jsenlas/KiCAD_Bak/Rozlozenie_pinov.png

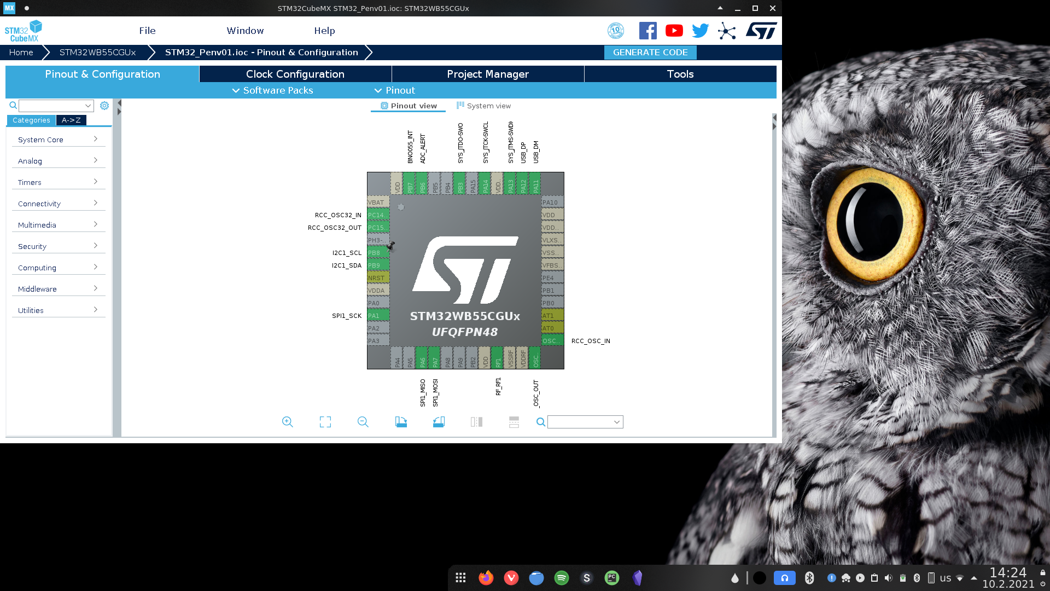
Rozlozenie_pinov.png
