jsenlas/KiCAD_Bak/README.md

# KiCAD_Bak
Bachelor thesis HW section - KiCAD
