jsenlas/KiCAD_Bak/Pinout.ods

1 | VBAT | Power |  | OK
2 | OSC32768IN |  | OSC | OK
3 | OSC32768OUT |  | OSC | OK
4 | PH3-BOOT0 | I/O | BOOT | OK
5 | PB8 | I/O | I2C1_SCL | OK
6 | PB9 | I/O | I2C1_SDA | OK
7 | NRST | Reset | NRST | OK
8 | VDDA | Power |  | OK
9 | PA0 | I/O
10 | PA1 | I/O | SPI1_SCK | OK
11 | PA2 | I/O
12 | PA3 | I/O
13 | PA4 | I/O | LED BLUE | OK | 10
14 | PA5 | I/O
15 | PA6 | I/O | SPI1_MISO | OK
16 | PA7 | I/O | SPI1_MOSI | OK
17 | PA8 | I/O
18 | PA9 | I/O
19 | PB2 | I/O
20 | VDD | Power |  | OK
21 | RF1 | MonoIO | RF_RF1 | Need check
22 | VSSRF | Power |  | OK
23 | VDDRF | Power |  | OK
24 | OSC_OUT | MonoIO | RCC_OSC_OUT | OK
25 | OSC_IN | MonoIO | RCC_OSC_IN | OK | 8
26 | AT0 | NC
27 | AT1 | NC
28 | PB0 | I/O
29 | PB1 | I/O
30 | PE4 | I/O
31 | VFBSMPS | Power |  | OK
32 | VSSSMPS | Power |  | OK
33 | VLXSMPS | Power |  | OK
34 | VDDSMPS | Power |  | OK
35 | VDD | Power |  | OK
36 | PA10 | I/O
37 | PA11 | I/O | USB_DM | OK
38 | PA12 | I/O | USB_DP | OK
39 | PA13 | I/O
40 | VDDUSB | Power |  | OK
41 | PA14 | I/O
42 | PA15 | I/O
43 | PB3 | I/O
44 | PB4 | I/O
45 | PB5 | I/O
46 | PB6 | I/O
47 | PB7 | I/O
48 | VDD | Power |  | OK | 9
ADS115 | OK
BNO055 | OK
