jsenlas/KiCAD_Bak/rozlozeniePinovv1.1.png

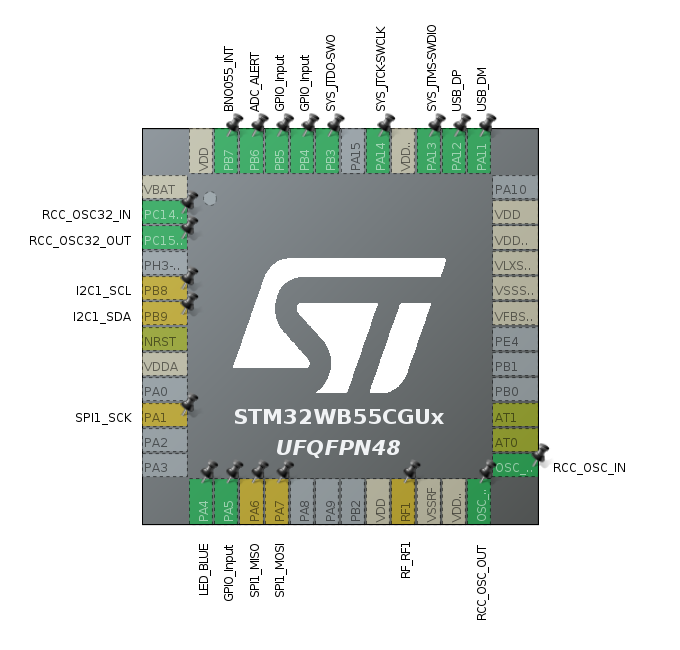
rozlozeniePinovv1.1.png
