jsenlas/KiCAD_Bak/BOM_Senčák HW.xlsx

Sheet: List 1
Položka | Množství | Stav | Odkaz | Poznámka
Adruino Nano | 1 | Vydáno | https://www.gme.cz/klon-arduino-nano-v3-0-r3-ch340g | Sakin osobní
Bluetooth modul HC-05 | 1 | Vydáno | https://www.gme.cz/bluetooth-modul-hc-05 | Sakin osobní
Akcelerometr GY-512 (S106) | 1 | Vydáno | https://blog.laskarduino.cz/gy-521-akcelerometr-gyro-3d-simulace/ | labiny SEM
Tlakový senzor SEN0065 DFROBOT | 5 | Vydáno | https://www.tme.eu/cz/details/df-sen0065/ostatni-cidla/dfrobot/sen0065/ | labiny SEM
Breadboard | 2 | Vydáno | https://www.adafruit.com/product/64 | labiny SEM
Adaptér micro SD | 1 | Vydáno | https://www.tme.eu/cz/details/df-dfr0229/adaptery/dfrobot/dfr0229/ | projekty
Odpory 30k, 102k, 10k | 20 x 3 | Vydáno | https://www.gme.cz/
Plochý vícežilový kabel VFL 10x0,15 | 5 | Vydáno | https://www.gme.cz/plochy-vicezilovy-kabel-vfl-10x0-15
Univerzální plošný spoj UP931EP | 1 | Vydáno | https://www.gme.cz/univelzalni-spoj-160-x-100-rm-2-54-kulate-body-din-41612
Věčný hrot k trafopáječce 1mm | 2 | Vydáno | https://www.gme.cz/vecny-hrot-k-trafopajecce-1mm
Cín 1mm 100g | 1 | Vydáno | https://www.gme.cz/cinova-pajka-cin-1mm-100g-sn99-3cu0-7nip-pbfree
microUSB pin UB-MC5BR3-SDWP604-4S-TF JST | 2 | v kanclu | https://www.tme.eu/cz/details/ubmc5br3sdwp6044s/konektory-usb-a-ieee1394/jst/ub-mc5br3-sdwp604-4s-tf/
MCP1640CT-I/CHY MICROCHIP měnič DC/DC | 5 | v kanclu | https://www.tme.eu/en/details/mcp1640ct-i_chy/voltage-regulators-dc-dc-circuits/microchip-technology/ | 5x lebo je to celkom lacne a potrebujem si to skusit na necisto
STM32WB55CGU6 Mikrokontrolér, STM32 | 1 | v kanclu | ST32_3D:STM32WB55CGU7 | https://www.mouser.sk/ProductDetail/STMicroelectronics/STM32WB55CGU6TR/?qs=vLWxofP3U2xiqLUzBgGZzw== |  | Mal by to byt tento, ten popisok je asi zly, neviemako sa tam dostal, radsej ho tam necham
FSR04BE Ohmite dotykové čidlo | 3 | v kanclu | https://cz.mouser.com/ProductDetail/Ohmite/FSR04BE/?qs=byeeYqUIh0N2f2m9cyusJg==
BNO055 9-axis gyroskopy, senzor pohybu | 1 | Objednáno | https://cz.mouser.com/ProductDetail/Bosch-Sensortec/BNO055/?qs=QhAb4EtQfbV8Z2YmISucWw== | Je celkom rozsireny a Bosch ma velku kniznicu
ADS1115IRUGR A/D prevodnik | 1 | v kanclu | https://cz.mouser.com/ProductDetail/Texas-Instruments/ADS1115IRUGR/?qs=IK5e5L0zOXhqw%2F8AHSSbuA== | Tento uz pouzivam v tom co mam
Krystal NX2012SA-32.768K-STD-MUB-1 | 1 | Objednáno | https://cz.mouser.com/ProductDetail/NDK/NX2012SA-32768K-STD-MUB-1/?qs=55YtniHzbhA%252B6%2Fl1MwFZaQ==
Doobjednať su tu vsetky suciastky so spravnymi poctami do objednavky. Na druhej stranke je zoznam vsetkych komponent v mojej scheme, zoskupene podla suciastok s poctami
100n C1,5,6,7,8,9,10,19,21 | 9 | Neobj | https://www.mouser.sk/ProductDetail/Yageo/CC0402JRX7R8BB104/?qs=tS%2FAHvPQ%2F56C6Jcuby2Lxg%3D%3D
100p C2 | 1 | Neobj | https://www.mouser.sk/ProductDetail/AVX/04026C101KAT2A/?qs=nyfP64xlqc%2FN9ABjcoge4g%3D%3D
4u7 C3,4,13 | 3 | Neobj | https://www.mouser.sk/ProductDetail/Murata-Electronics/GRT155C80J475ME13D/?qs=rrS6PyfT74fcISTT255Zog%3D%3D
1u C11,16 | 2 | Neobj | https://www.mouser.sk/ProductDetail/Taiyo-Yuden/LMK105BJ105MVHF/?qs=sBf%2Fb4nBSlfFq2d5eQRmhw%3D%3D
100n C12 | 1 | Neobj | https://www.mouser.sk/ProductDetail/Yageo/CC0201KRX6S6BB104/?qs=tS%2FAHvPQ%2F55Jn9CaHON1Eg%3D%3D |  | Bosch chce este jeden
10n C14 | 1 | Neobj | https://www.mouser.sk/ProductDetail/Murata-Electronics/GCB155M91A103KE01D/?qs=rrS6PyfT74f9uJD9nibAXg%3D%3D
100n C15 | 1 | Neobj | https://www.mouser.sk/ProductDetail/AVX/04026D104KAT2A/?qs=LLG2yGGJ5NhILwMziGI8Xg%3D%3D
4p3 C17,18 | 2 | Neobj | https://www.mouser.sk/ProductDetail/KEMET/C0402C439B5GACTU/?qs=sGAEpiMZZMuMW9TJLBQkXtQELi8n00gZ9Z2MeBGZChc%3D
1u C20,22,23 | 3 | Neobj | https://www.mouser.sk/ProductDetail/Murata-Electronics/GRT155C80J105KE01D/?qs=drgMNd%252BkGPPklTH3DFv1UA%3D%3D
22p C24,25 | 2 | Neobj | https://www.mouser.sk/ProductDetail/KEMET/C0402C220J5GAC7411/?qs=G1g%2FCI6Oc7%252BpkCDhmQb%252B2A%3D%3D
10u C_1 | 1 | Neobj | https://www.mouser.sk/ProductDetail/Murata-Electronics/GRJ155R60J106ME11D/?qs=I53XXhTNm8s0qq2xY2TjBg%3D%3D
D1 Blue | 1 | Neobj | https://www.mouser.sk/ProductDetail/OSRAM-Opto-Semiconductors/LG-L29K-F2J1-24-Z/
D3 | 1 | Neobj | https://www.mouser.sk/ProductDetail/Diodes-Incorporated/1N4148WT-7/?qs=FITO%2F%2FQgYDlMYETivVNccQ%3D%3D
ed1 | 1 | Neobj | https://www.mouser.sk/ProductDetail/Taoglas/RECE-20279-001E-01/?qs=WUa1z%2FNV9%252B3mVij1vDlP0A%3D%3D
FB1 BLM15AX601SN1D | 1 | Neobj | https://www.mouser.sk/ProductDetail/Murata-Electronics/BLM15AX601SN1D/?qs=MY6wChARw2zrjX4xpWbUQA%3D%3D
FB2,3 MMZ2012Y152BTD25 | 2 | Neobj | https://www.mouser.sk/ProductDetail/TDK/MMZ2012Y152BTD25?qs=z4cHi%252BdwYubbRRUCER1uug%3D%3D
FL1 MLPF-WB55-01E3 | 1 | Neobj | https://www.mouser.sk/ProductDetail/STMicroelectronics/MLPF-WB55-02E3/
IC1 LD3985M33R | 1 | Neobj | https://www.mouser.sk/ProductDetail/STMicroelectronics/LD3985M33R/
IC2 USBLC6-2SC6 | 1 | Neobj | https://www.mouser.co.uk/ProductDetail/STMicroelectronics/USBLC6-2SC6/?qs=po45yt2pPpu%2FhNIlwQdTlg%3D%3D
J1 USB | 1 | v kanclu | https://www.tme.eu/cz/details/ubmc5br3sdwp6044s/konektory-usb-a-ieee1394/jst/ub-mc5br3-sdwp604-4s-tf/
L1 | 1 | Neobj | https://www.mouser.sk/ProductDetail/TDK/MLZ1608E4R7MT/?qs=h0qUPQyyc9d3MvAbpnb%252BVQ%3D%3D
L2 | 1 | Neobj | https://www.mouser.sk/ProductDetail/Bourns/PM0603-10NJ-RC/?qs=hDfDVdb8C4gaFG%2FjJv%252Bsvg%3D%3D
L3 | 1 | Neobj | https://www.mouser.sk/ProductDetail/KEMET/L0603C10NJRMST/?qs=v1sh8PPj49i58Ne9vk%2F5nA%3D%3D
100K LED R1,5,7,8,9, | 5 | Neobj | https://www.mouser.sk/ProductDetail/Welwyn-Components-TT-Electronics/WCR0402-100KFA/
10K R2,3,4,6,10,11,12 | 7 | Neobj | https://www.mouser.sk/ProductDetail/Vishay-Dale/CRCW040210K0FKEDC/?qs=E3Y5ESvWgWPiNLcGzwCGPg%3D%3D
976K R_1 | 1 | Neobj | https://www.mouser.sk/ProductDetail/Vishay-Dale/CRCW0402976KFKED/
562K R_2 | 1 | Neobj | https://www.mouser.sk/ProductDetail/Vishay-Dale/CRCW0402562KFKED/
S1,2 MLL1200S | 2 | Neobj | https://www.mouser.sk/ProductDetail/TE-Connectivity-PB/MLL1200S/?qs=%252BHgkcFtPSlhaU4bDJZHWiQ%3D%3D
U1 | 1 | v kanclu | https://www.tme.eu/en/details/mcp1640ct-i_chy/voltage-regulators-dc-dc-circuits/microchip-technology/
U2 | 1 | v kanclu | https://www.mouser.sk/ProductDetail/STMicroelectronics/STM32WB55CGU6TR/?qs=vLWxofP3U2xiqLUzBgGZzw==
U4 | 1 | Objednáno | https://cz.mouser.com/ProductDetail/Bosch-Sensortec/BNO055/?qs=QhAb4EtQfbV8Z2YmISucWw==
U5 | 1 | v kanclu | https://cz.mouser.com/ProductDetail/Texas-Instruments/ADS1115IRUGR/?qs=IK5e5L0zOXhqw%2F8AHSSbuA==
Y1 | 1 | Neobj | https://www.mouser.sk/ProductDetail/NDK/NX2520SA-32000M-STD-CSW-2/
Y2,3 | 1 | Neobj | https://cz.mouser.com/ProductDetail/NDK/NX2012SA-32768K-STD-MUB-1/?qs=55YtniHzbhA%252B6%2Fl1MwFZaQ==
FSR04 | 3 | v kanclu | https://cz.mouser.com/ProductDetail/Ohmite/FSR04BE/?qs=byeeYqUIh0N2f2m9cyusJg==
Dalsie
Shottky |  | Neobj | https://www.mouser.sk/ProductDetail/Vishay-Semiconductors/BAT54W-HE3-08/?qs=ESFF34UzhwicvMTEyztCgA%3D%3D
LQG15HS2N7S02D |  | Neobj | https://www.tme.eu/en/details/lqg15hs2n7s02d/smd-0402-inductors/murata/
Antena FXP75.07.0045B |  | Neobj | https://www.mouser.sk/ProductDetail/Taoglas/FXP75070045B/?qs=gAfoL%252BRo%2FrIkDsQ4mxrg%2Fw%3D%3D
TOTO su suciastky ktore nechcem, zistil som ze ich netreba, ci uz som ich nahradil inymi alebo som zmenil dizajn podla niektorej application note
RF OLD
SMD Multilayer Ceramic Capacitor GRM1555C1H1R8BA01D |  | X | https://uk.farnell.com/murata/grm1555c1h1r8ba01d/cap-1-8pf-50v-c0g-np0-0402/dp/2456093
Band Pass Filter 2.45GHz |  | X | https://www.mouser.sk/ProductDetail/TDK/DEA162450BT-1295A1/?qs=r5DSvlrkXmJWOg7G%2F4pSbg%3D%3D
Band Pass Filter 2.45GHz Alternativa. Len jedno treba vybrat |  | X | https://www.mouser.sk/ProductDetail/Taiyo-Yuden/FI168B245001-T/?qs=I6KAKw0tg2xuNK6sNGcrog%3D%3D
4.7 uH 1640 L |  |  | https://www.mouser.sk/ProductDetail/Wurth-Elektronik/744030004/
ECMF02-2AMX6 | 2 | X | https://www.mouser.sk/productdetail/stmicroelectronics/ecmf02-2amx6?qs=raAh8RbVwI65u5gmT42%2Flg==
ESDA7P60-1U1M | 2 | X | https://www.mouser.sk/ProductDetail/STMicroelectronics/ESDA7P60-1U1M/

Sheet: List 2
Suciastky | Pocet | Stav | Odkaz | Zoznam vsetkych komponent, ktore mam na doske spolu s poctami, podla tohoto NEOBJEDNAVAT
100n C1,5,6,7,8,9,10,19,21 | 9 | Neobj | https://www.mouser.sk/ProductDetail/Yageo/CC0402JRX7R8BB104/?qs=tS%2FAHvPQ%2F56C6Jcuby2Lxg%3D%3D
100p C2 | 1 | Neobj | https://www.mouser.sk/ProductDetail/AVX/04026C101KAT2A/?qs=nyfP64xlqc%2FN9ABjcoge4g%3D%3D
4u7 C3,4,13 | 3 | Neobj | https://www.mouser.sk/ProductDetail/Murata-Electronics/GRT155C80J475ME13D/?qs=rrS6PyfT74fcISTT255Zog%3D%3D
1u C11,16 | 2 | Neobj | https://www.mouser.sk/ProductDetail/Taiyo-Yuden/LMK105BJ105MVHF/?qs=sBf%2Fb4nBSlfFq2d5eQRmhw%3D%3D
100n C12 | 1 | Neobj | https://www.mouser.sk/ProductDetail/Yageo/CC0201KRX6S6BB104/?qs=tS%2FAHvPQ%2F55Jn9CaHON1Eg%3D%3D
10n C14 | 1 | Neobj | https://www.mouser.sk/ProductDetail/Murata-Electronics/GCB155M91A103KE01D/?qs=rrS6PyfT74f9uJD9nibAXg%3D%3D
100n C15 | 1 | Neobj | https://www.mouser.sk/ProductDetail/AVX/04026D104KAT2A/?qs=LLG2yGGJ5NhILwMziGI8Xg%3D%3D
4p3 C17,18 | 2 | Neobj | https://www.mouser.sk/ProductDetail/KEMET/C0402C439B5GACTU/?qs=sGAEpiMZZMuMW9TJLBQkXtQELi8n00gZ9Z2MeBGZChc%3D
1u C20,22,23 | 3 | Neobj | https://www.mouser.sk/ProductDetail/Murata-Electronics/GRT155C80J105KE01D/?qs=drgMNd%252BkGPPklTH3DFv1UA%3D%3D
22p C24,25 | 2 | Neobj | https://www.mouser.sk/ProductDetail/KEMET/C0402C220J5GAC7411/?qs=G1g%2FCI6Oc7%252BpkCDhmQb%252B2A%3D%3D
10u C_1 | 1 | Neobj | https://www.mouser.sk/ProductDetail/Murata-Electronics/GRJ155R60J106ME11D/?qs=I53XXhTNm8s0qq2xY2TjBg%3D%3D
D1 Blue | 1 | Neobj | https://www.mouser.sk/ProductDetail/OSRAM-Opto-Semiconductors/LG-L29K-F2J1-24-Z/
D3 | 1 | Neobj | https://www.mouser.sk/ProductDetail/Diodes-Incorporated/1N4148WT-7/?qs=FITO%2F%2FQgYDlMYETivVNccQ%3D%3D
ed1 | 1 | Neobj | https://www.mouser.sk/ProductDetail/Taoglas/RECE-20279-001E-01/?qs=WUa1z%2FNV9%252B3mVij1vDlP0A%3D%3D
FB1 BLM15AX601SN1D | 1 | Neobj | https://www.mouser.sk/ProductDetail/Murata-Electronics/BLM15AX601SN1D/?qs=MY6wChARw2zrjX4xpWbUQA%3D%3D
FB2,3 MMZ2012Y152BTD25 | 2 | Neobj | https://www.mouser.sk/ProductDetail/TDK/MMZ1005A152ETD25/?qs=pvNC7ksEVIcCEaWw1qDBfg%3D%3D
FL1 MLPF-WB55-01E3 | 1 | Neobj | https://www.mouser.sk/ProductDetail/STMicroelectronics/MLPF-WB55-02E3/
IC1 LD3985M33R | 1 | Neobj | https://www.mouser.sk/ProductDetail/STMicroelectronics/LD3985M33R/
IC2 | 1 | Neobj | https://www.mouser.co.uk/ProductDetail/STMicroelectronics/USBLC6-2SC6/?qs=po45yt2pPpu%2FhNIlwQdTlg%3D%3D
J1 USB | 1 | v kanclu | https://www.tme.eu/cz/details/ubmc5br3sdwp6044s/konektory-usb-a-ieee1394/jst/ub-mc5br3-sdwp604-4s-tf/
L1 | 1 | Neobj | https://www.mouser.sk/ProductDetail/TDK/MLZ1608E4R7MT/?qs=h0qUPQyyc9d3MvAbpnb%252BVQ%3D%3D
L2 | 1 | Neobj | https://www.mouser.sk/ProductDetail/Bourns/PM0603-10NJ-RC/?qs=hDfDVdb8C4gaFG%2FjJv%252Bsvg%3D%3D
L3 | 1 | Neobj | https://www.mouser.sk/ProductDetail/KEMET/L0603C10NJRMST/?qs=v1sh8PPj49i58Ne9vk%2F5nA%3D%3D
100K LED R1,5,7,8,9, | 5 | Neobj | https://www.mouser.sk/ProductDetail/Welwyn-Components-TT-Electronics/WCR0402-100KFA/
10K R2,3,4,6,10,11,12 | 7 | Neobj | https://www.mouser.sk/ProductDetail/Vishay-Dale/CRCW040210K0FKEDC/?qs=E3Y5ESvWgWPiNLcGzwCGPg%3D%3D
976K R_1 | 1 | Neobj | https://www.mouser.sk/ProductDetail/Vishay-Dale/CRCW0402976KFKED/
562K R_2 | 1 | Neobj | https://www.mouser.sk/ProductDetail/Vishay-Dale/CRCW0402562KFKED/
S1,2 MLL1200S | 2 | Neobj | https://www.mouser.sk/ProductDetail/TE-Connectivity-PB/MLL1200S/?qs=%252BHgkcFtPSlhaU4bDJZHWiQ%3D%3D
U1 | 1 | v kanclu | https://www.tme.eu/en/details/mcp1640ct-i_chy/voltage-regulators-dc-dc-circuits/microchip-technology/
U2 | 1 | v kanclu | https://www.mouser.sk/ProductDetail/STMicroelectronics/STM32WB55CGU6TR/?qs=vLWxofP3U2xiqLUzBgGZzw==
U4 | 1 | Objednáno | https://cz.mouser.com/ProductDetail/Bosch-Sensortec/BNO055/?qs=QhAb4EtQfbV8Z2YmISucWw==
U5 | 1 | v kanclu | https://cz.mouser.com/ProductDetail/Texas-Instruments/ADS1115IRUGR/?qs=IK5e5L0zOXhqw%2F8AHSSbuA==
Y1 | 1 | Neobj | https://www.mouser.sk/ProductDetail/NDK/NX2520SA-32000M-STD-CSW-2/
Y2,3 | 2 | Objednáno/neobj | https://cz.mouser.com/ProductDetail/NDK/NX2012SA-32768K-STD-MUB-1/?qs=55YtniHzbhA%252B6%2Fl1MwFZaQ==
FSR04 | 3 | v kanclu | https://cz.mouser.com/ProductDetail/Ohmite/FSR04BE/?qs=byeeYqUIh0N2f2m9cyusJg==
Zmeny v suciastkach
FB1 Z0805C601BSMST | 1 | Neobj | https://www.mouser.sk/ProductDetail/KEMET/Z0805C601BSMST/?qs=v1sh8PPj49jmDD01hjhyZg==
D1 Blue | 1 | Neobj | https://www.mouser.sk/ProductDetail/ROHM-Semiconductor/SMLP13BC8TT86/?qs=9Cg39qEKpi6LOVes3%252Bc%2Fag%3D%3D
FB2,3 MMZ2012Y152BTD25 | 2 | Neobj | https://www.mouser.sk/ProductDetail/TDK/MMZ2012Y152BTD25?qs=z4cHi%252BdwYubbRRUCER1uug%3D%3D
