jsenlas/KiCAD_Bak/STM32WB55CG/STM32WB55_QFN48_IPD_REF_BOARD/01-Schéma-pdf/Schematic_STM32WB55_DB_QFN48_IPD.PDF

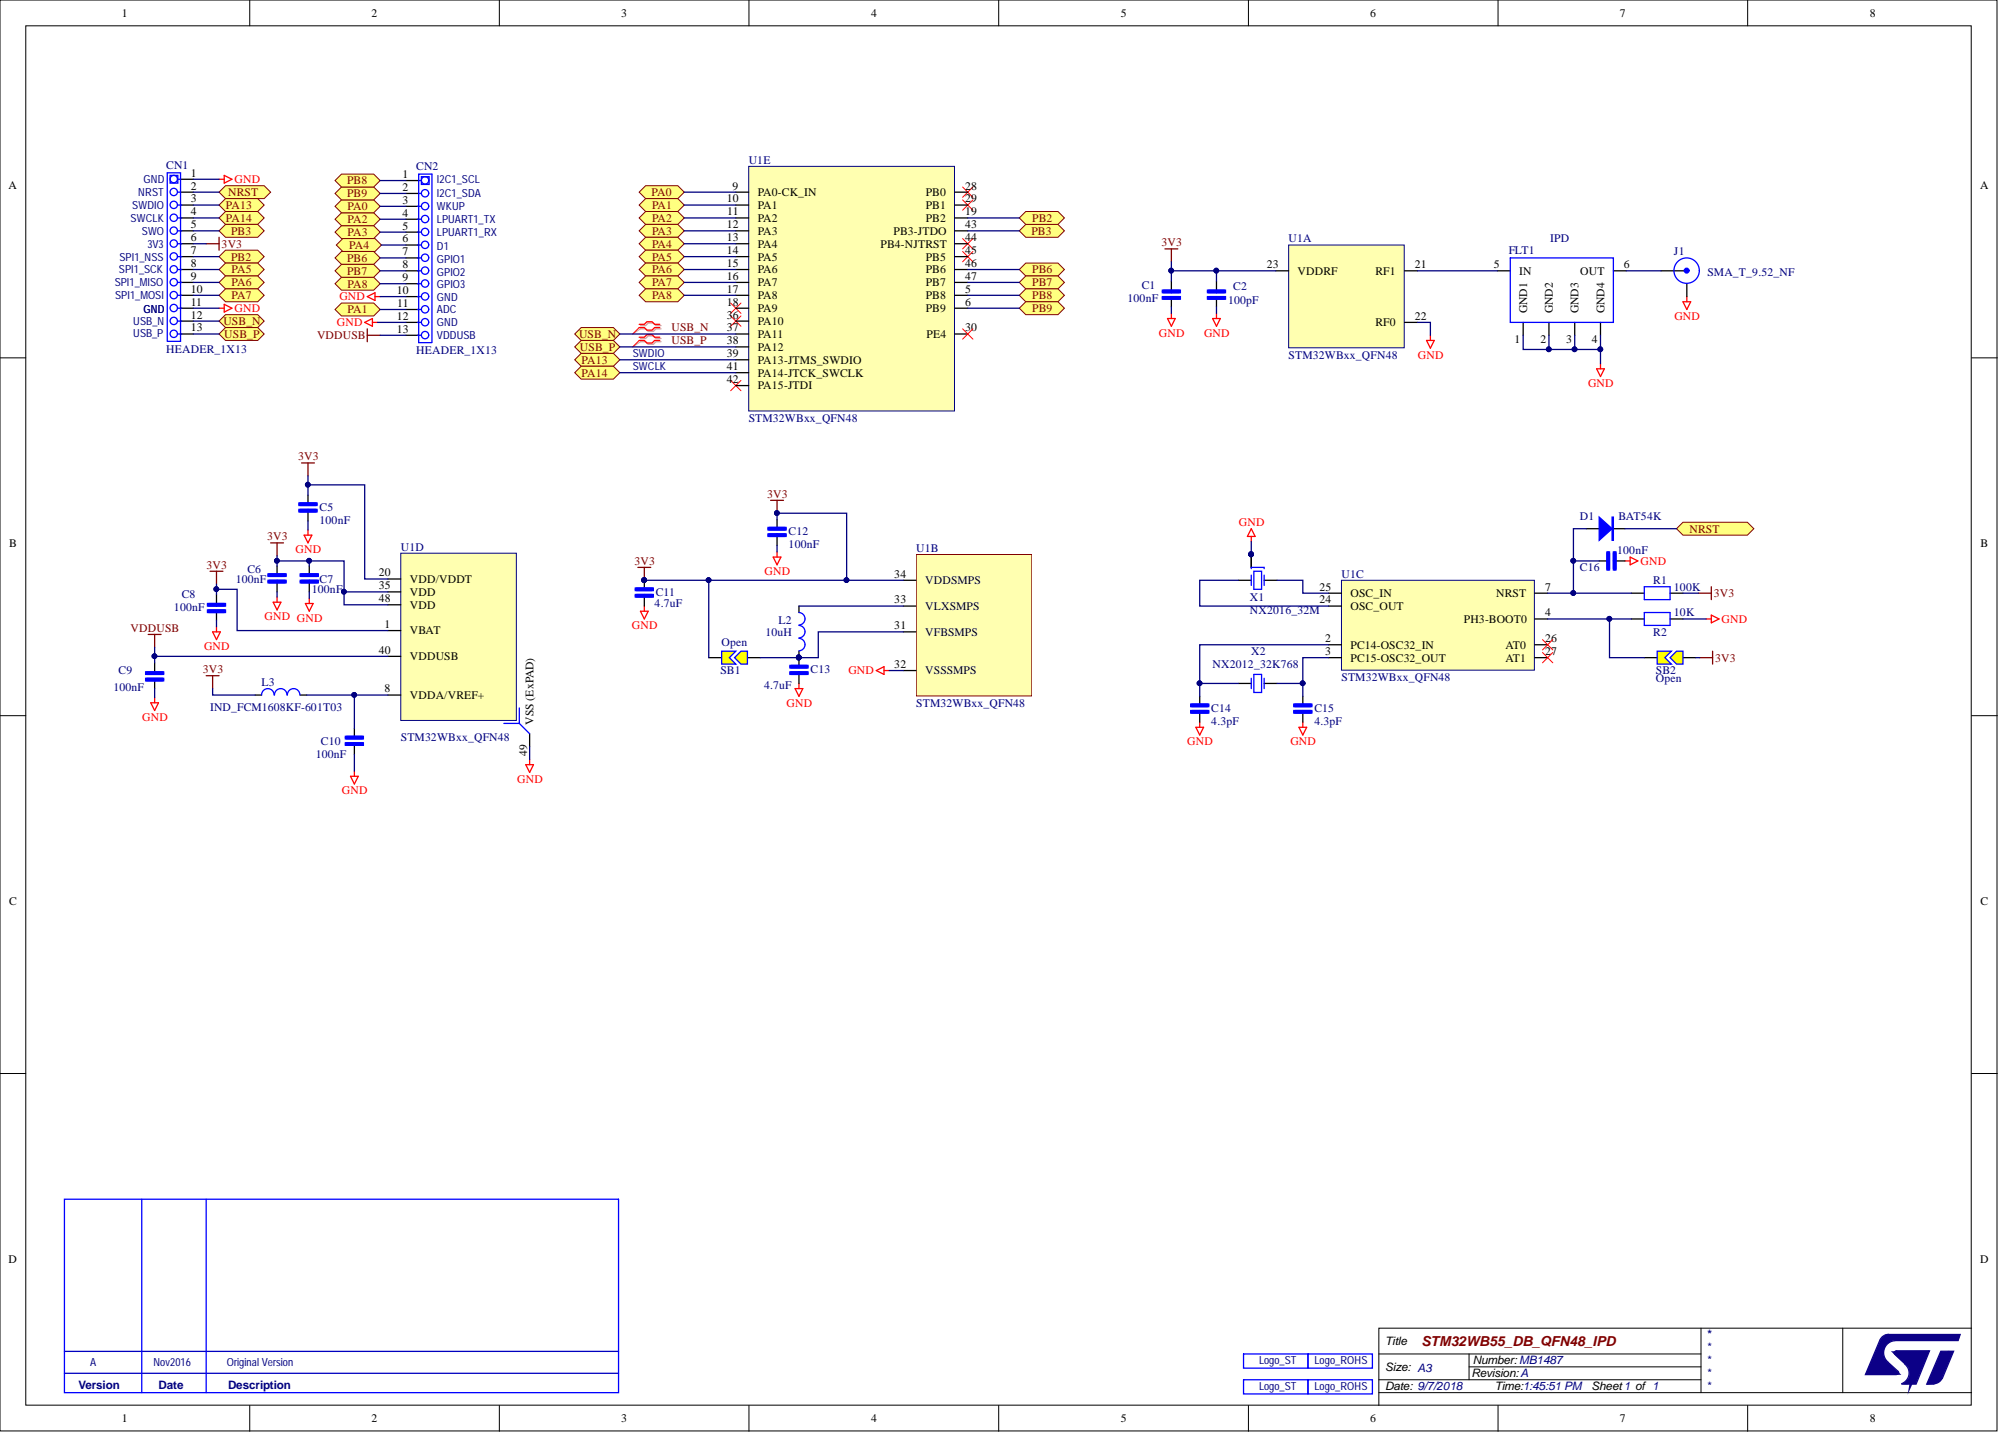
[picture p3: page 1]
