jsenlas/KiCAD_Bak/STM32WB55CG/STM32WB55_QFN48_IPD_REF_BOARD/04-Plan d'équipement-pdf/Assembly_Bottom_STM32WB55_DB_QFN48_IPD.PDF

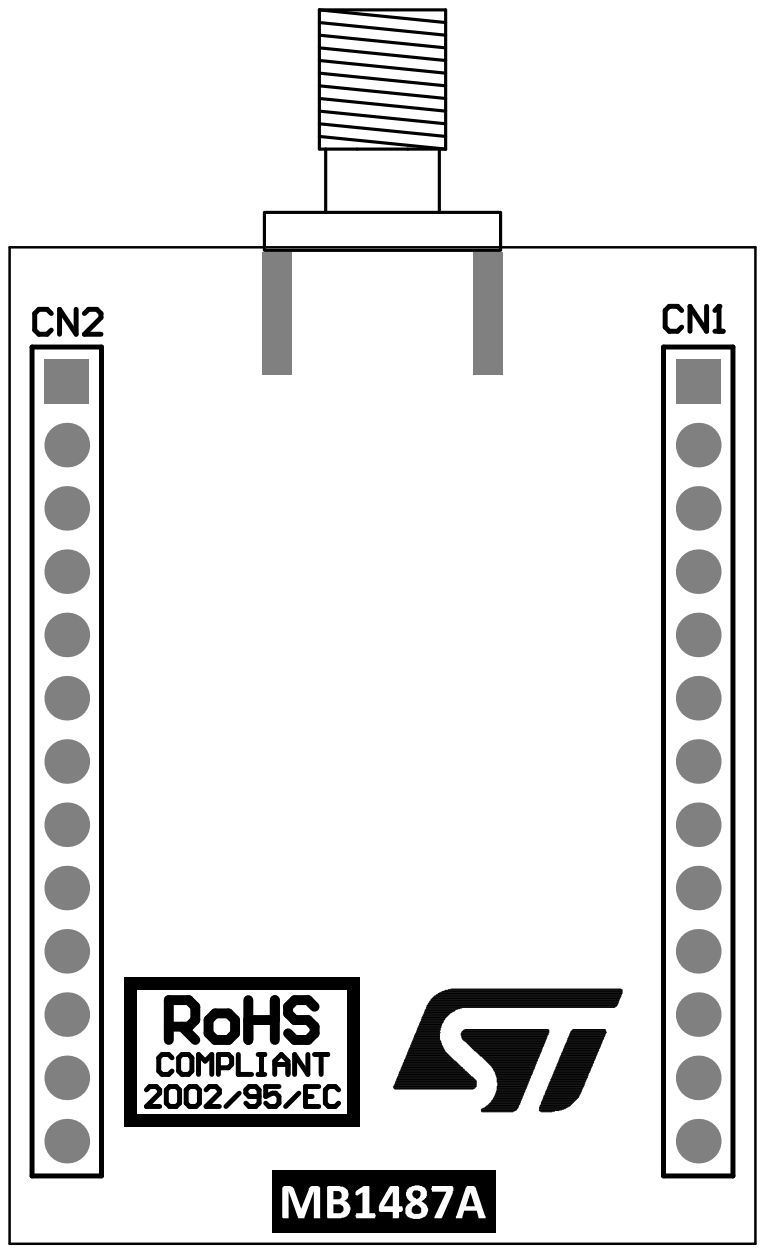
[picture p4: page 1]
