jsenlas/KiCAD_Bak/schv01.3.pdf

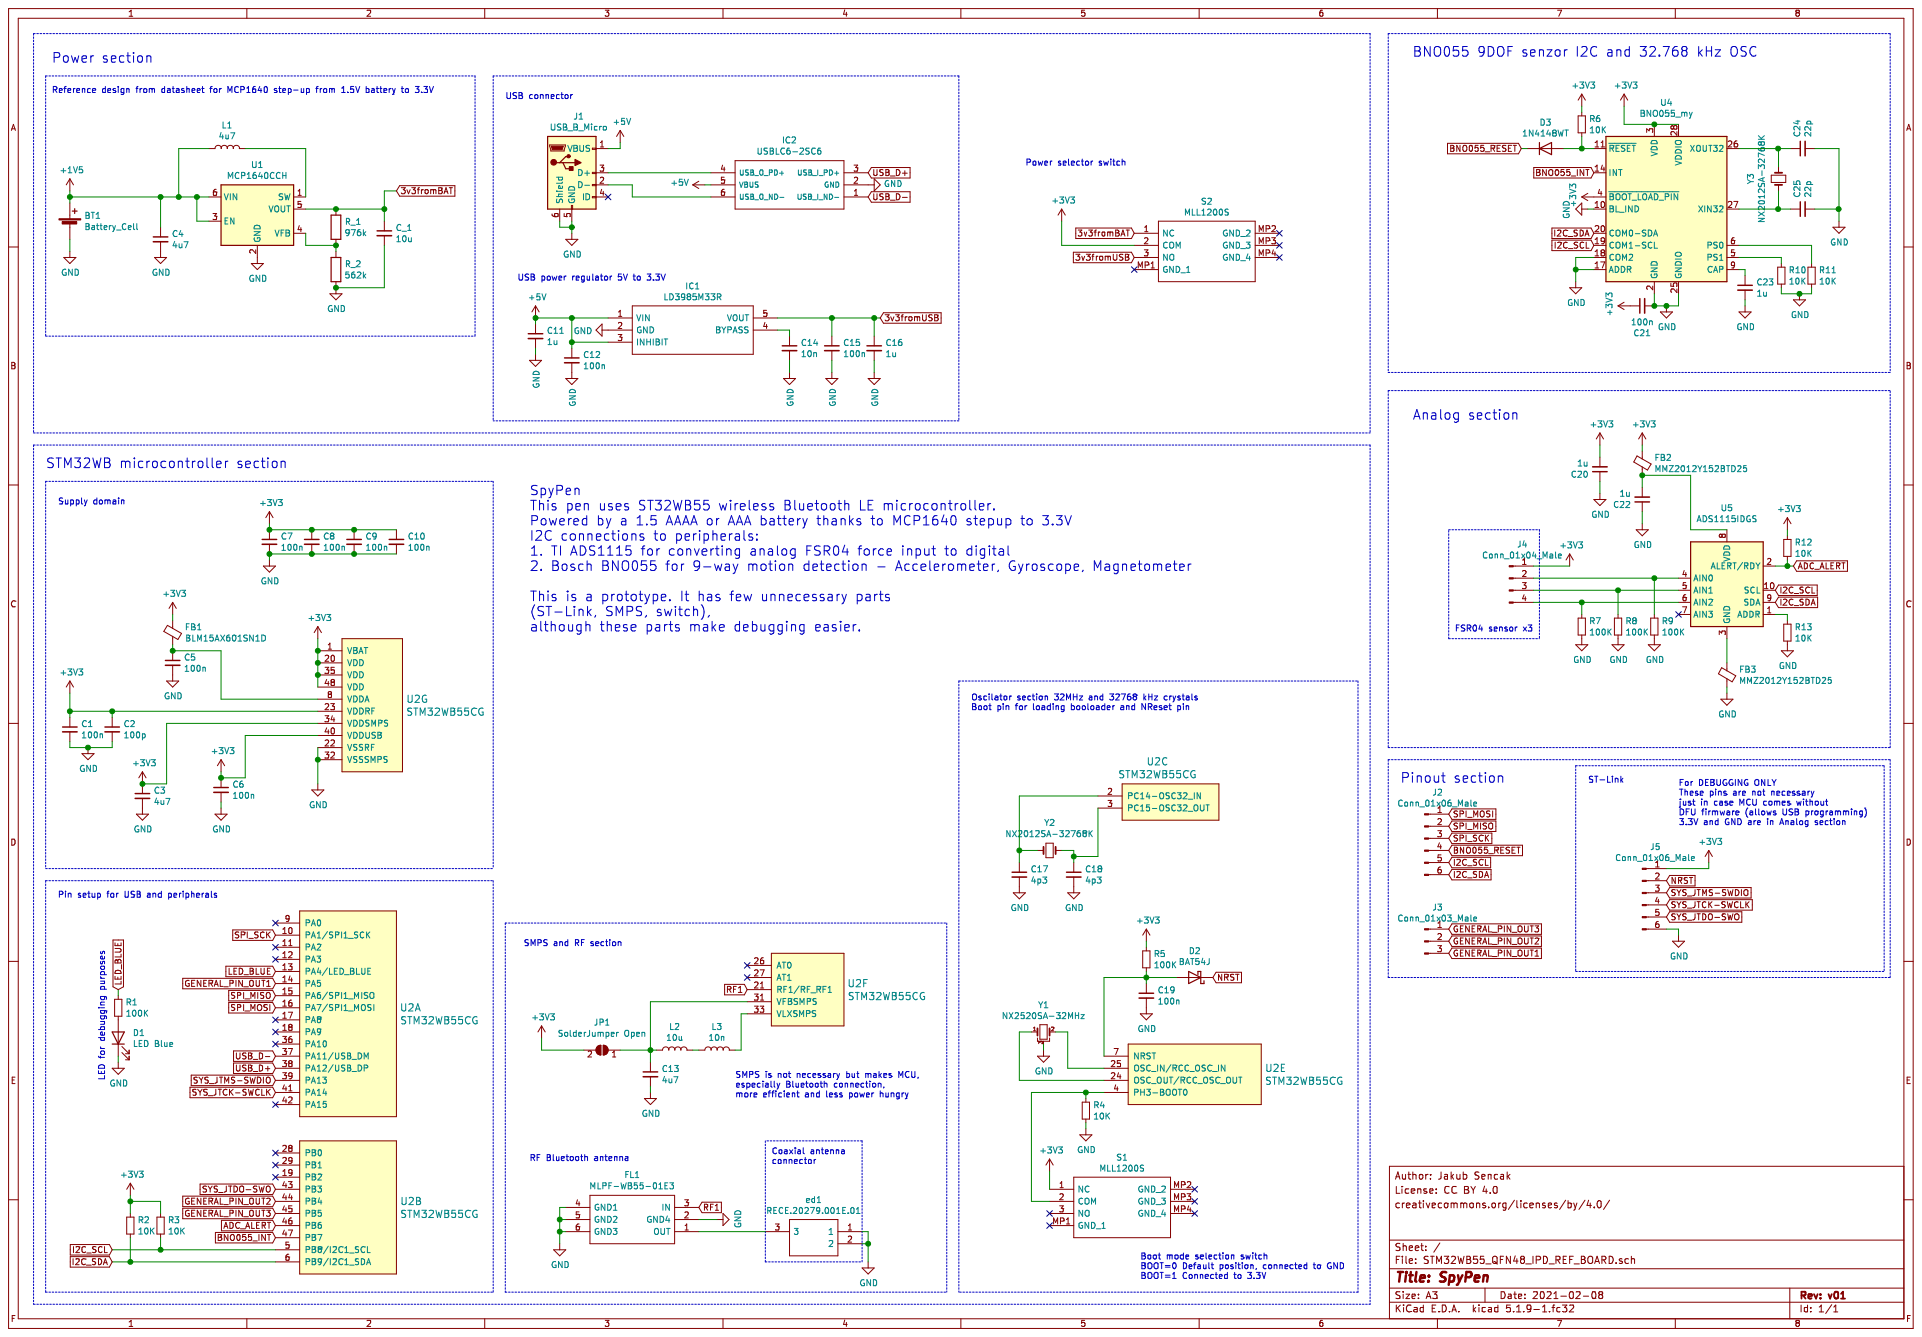
[picture p6: page 1]
