jsenlas/KiCAD_Bak/schv01.2.pdf

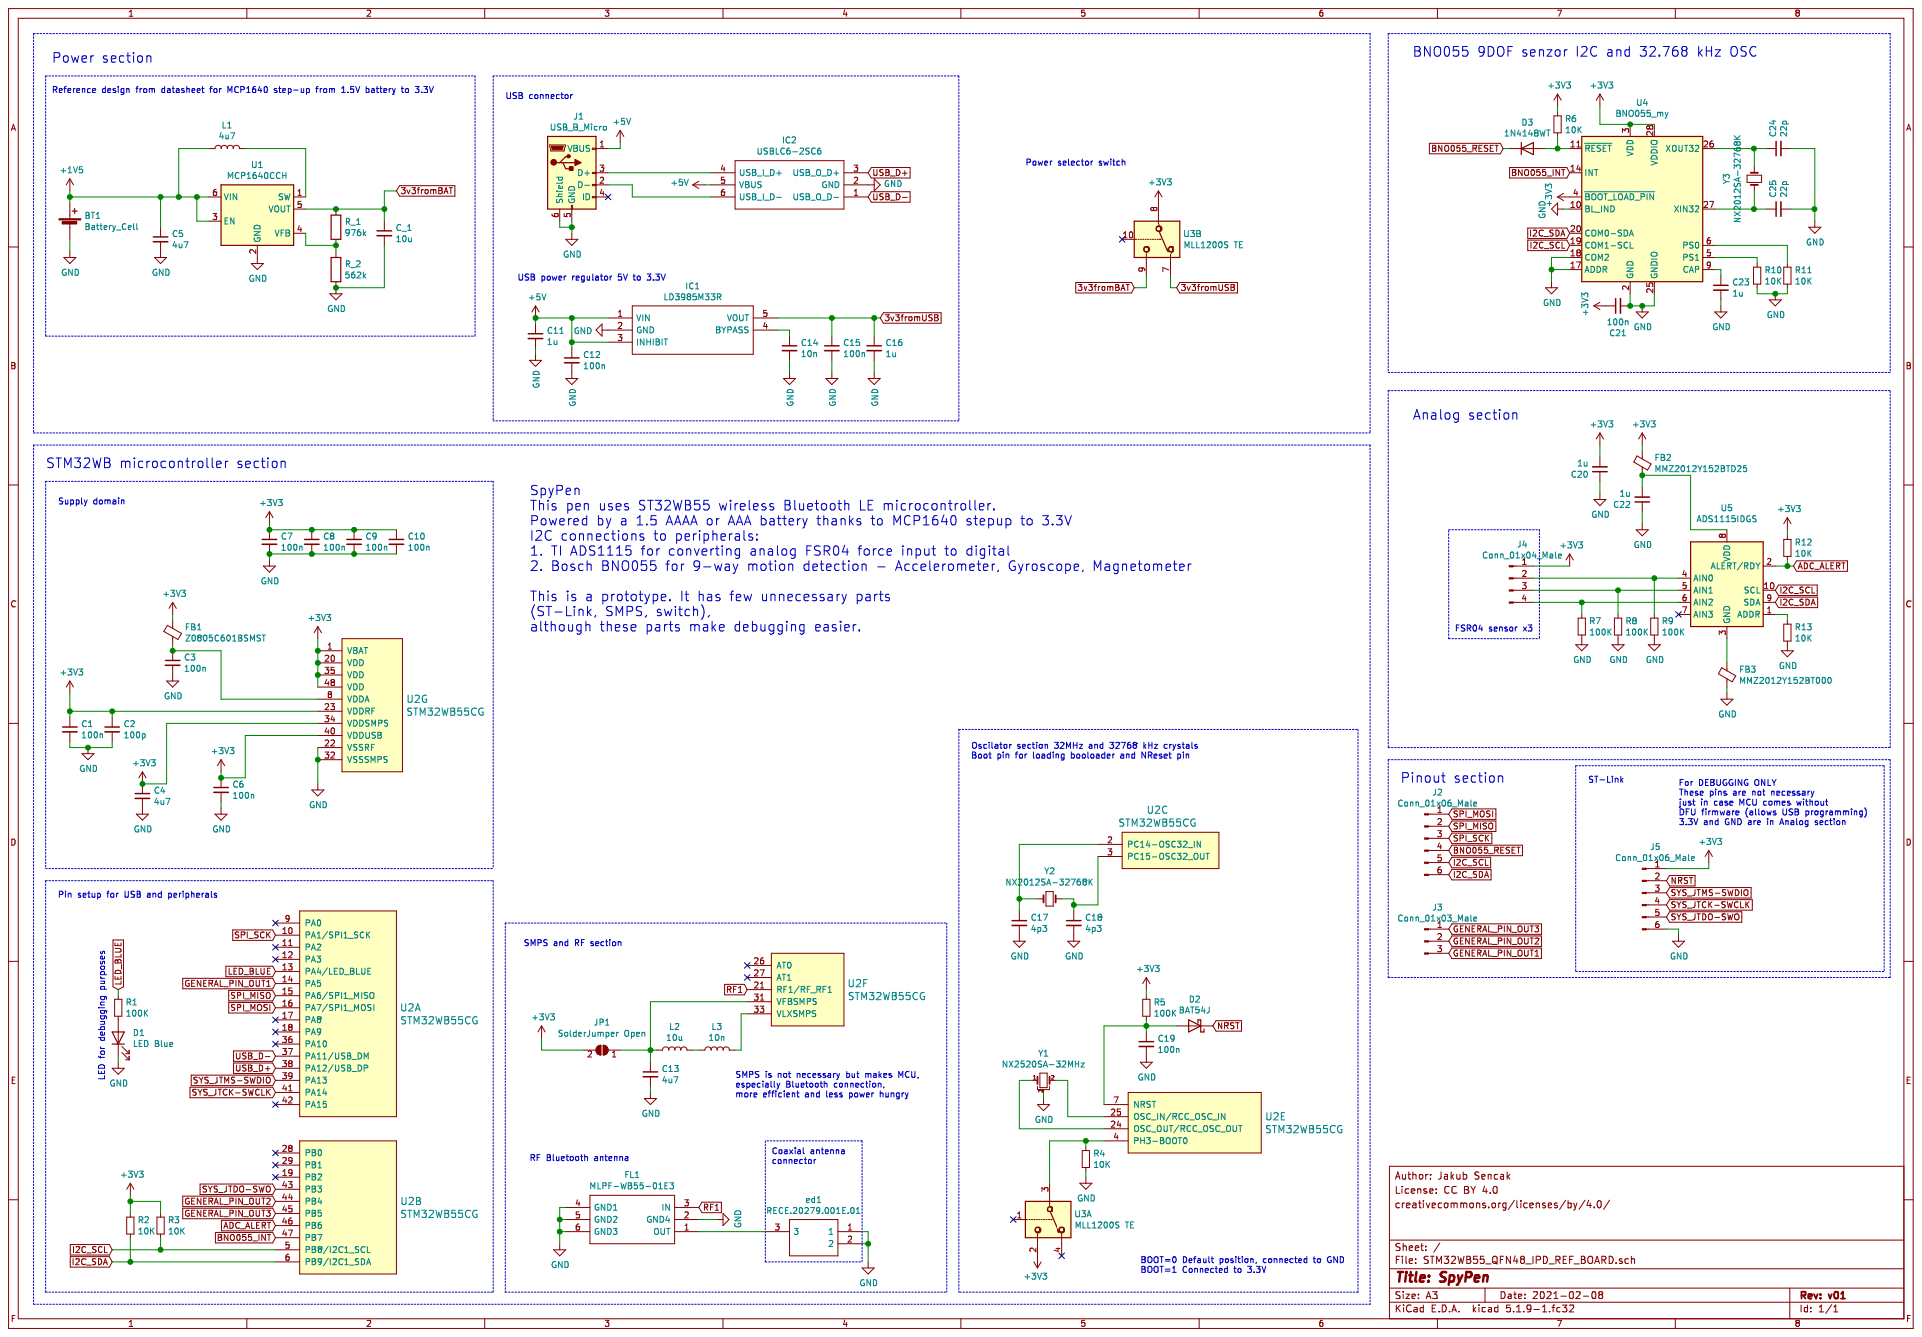
[picture p7: page 1]
