jsenlas/KiCAD_Bak/schv01.1.pdf

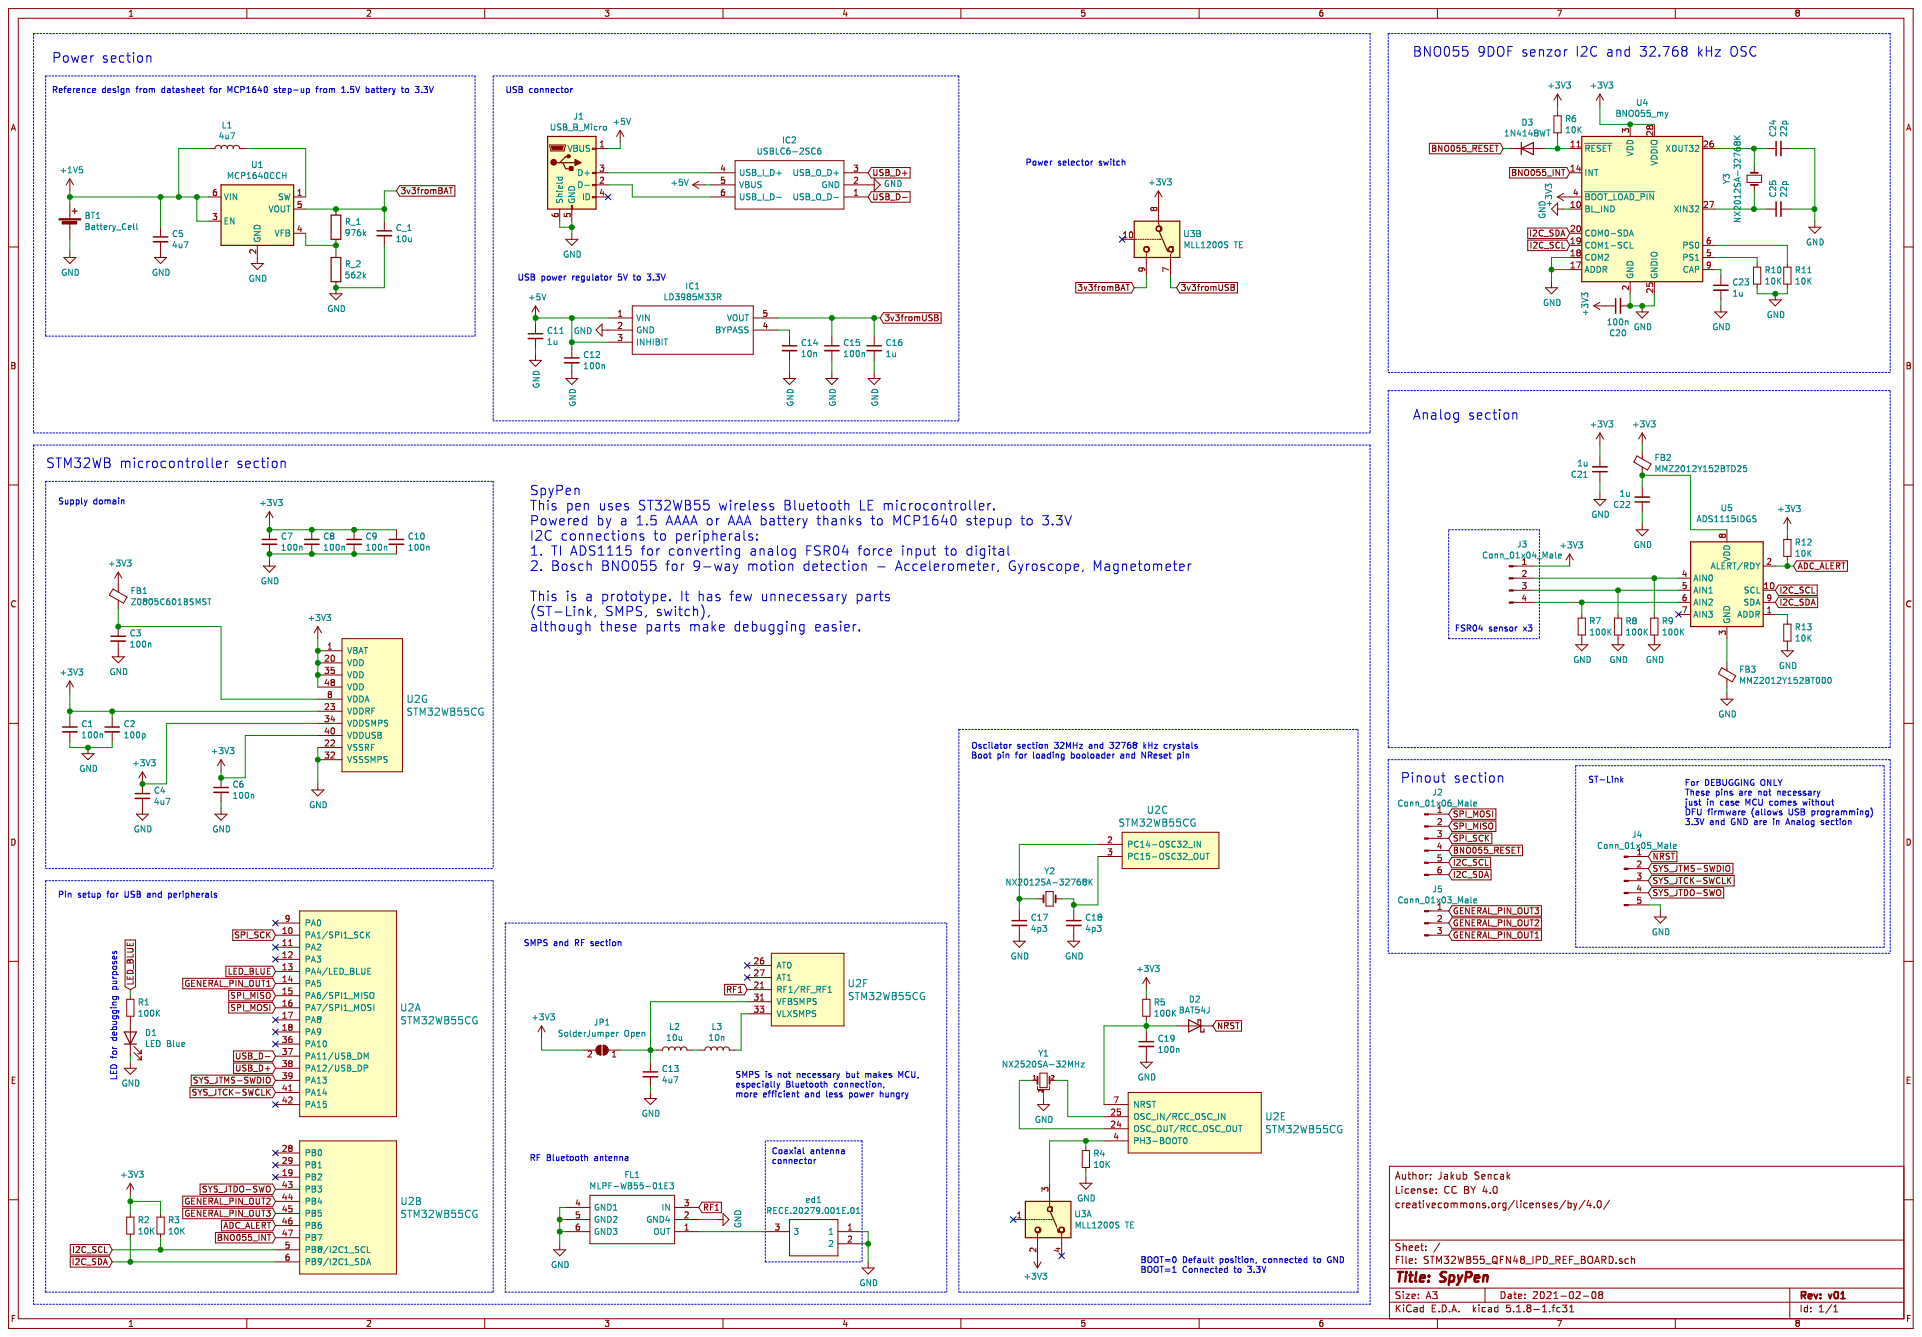
[picture p8: page 1]
