jsenlas/KiCAD_Bak/schv01.pdf

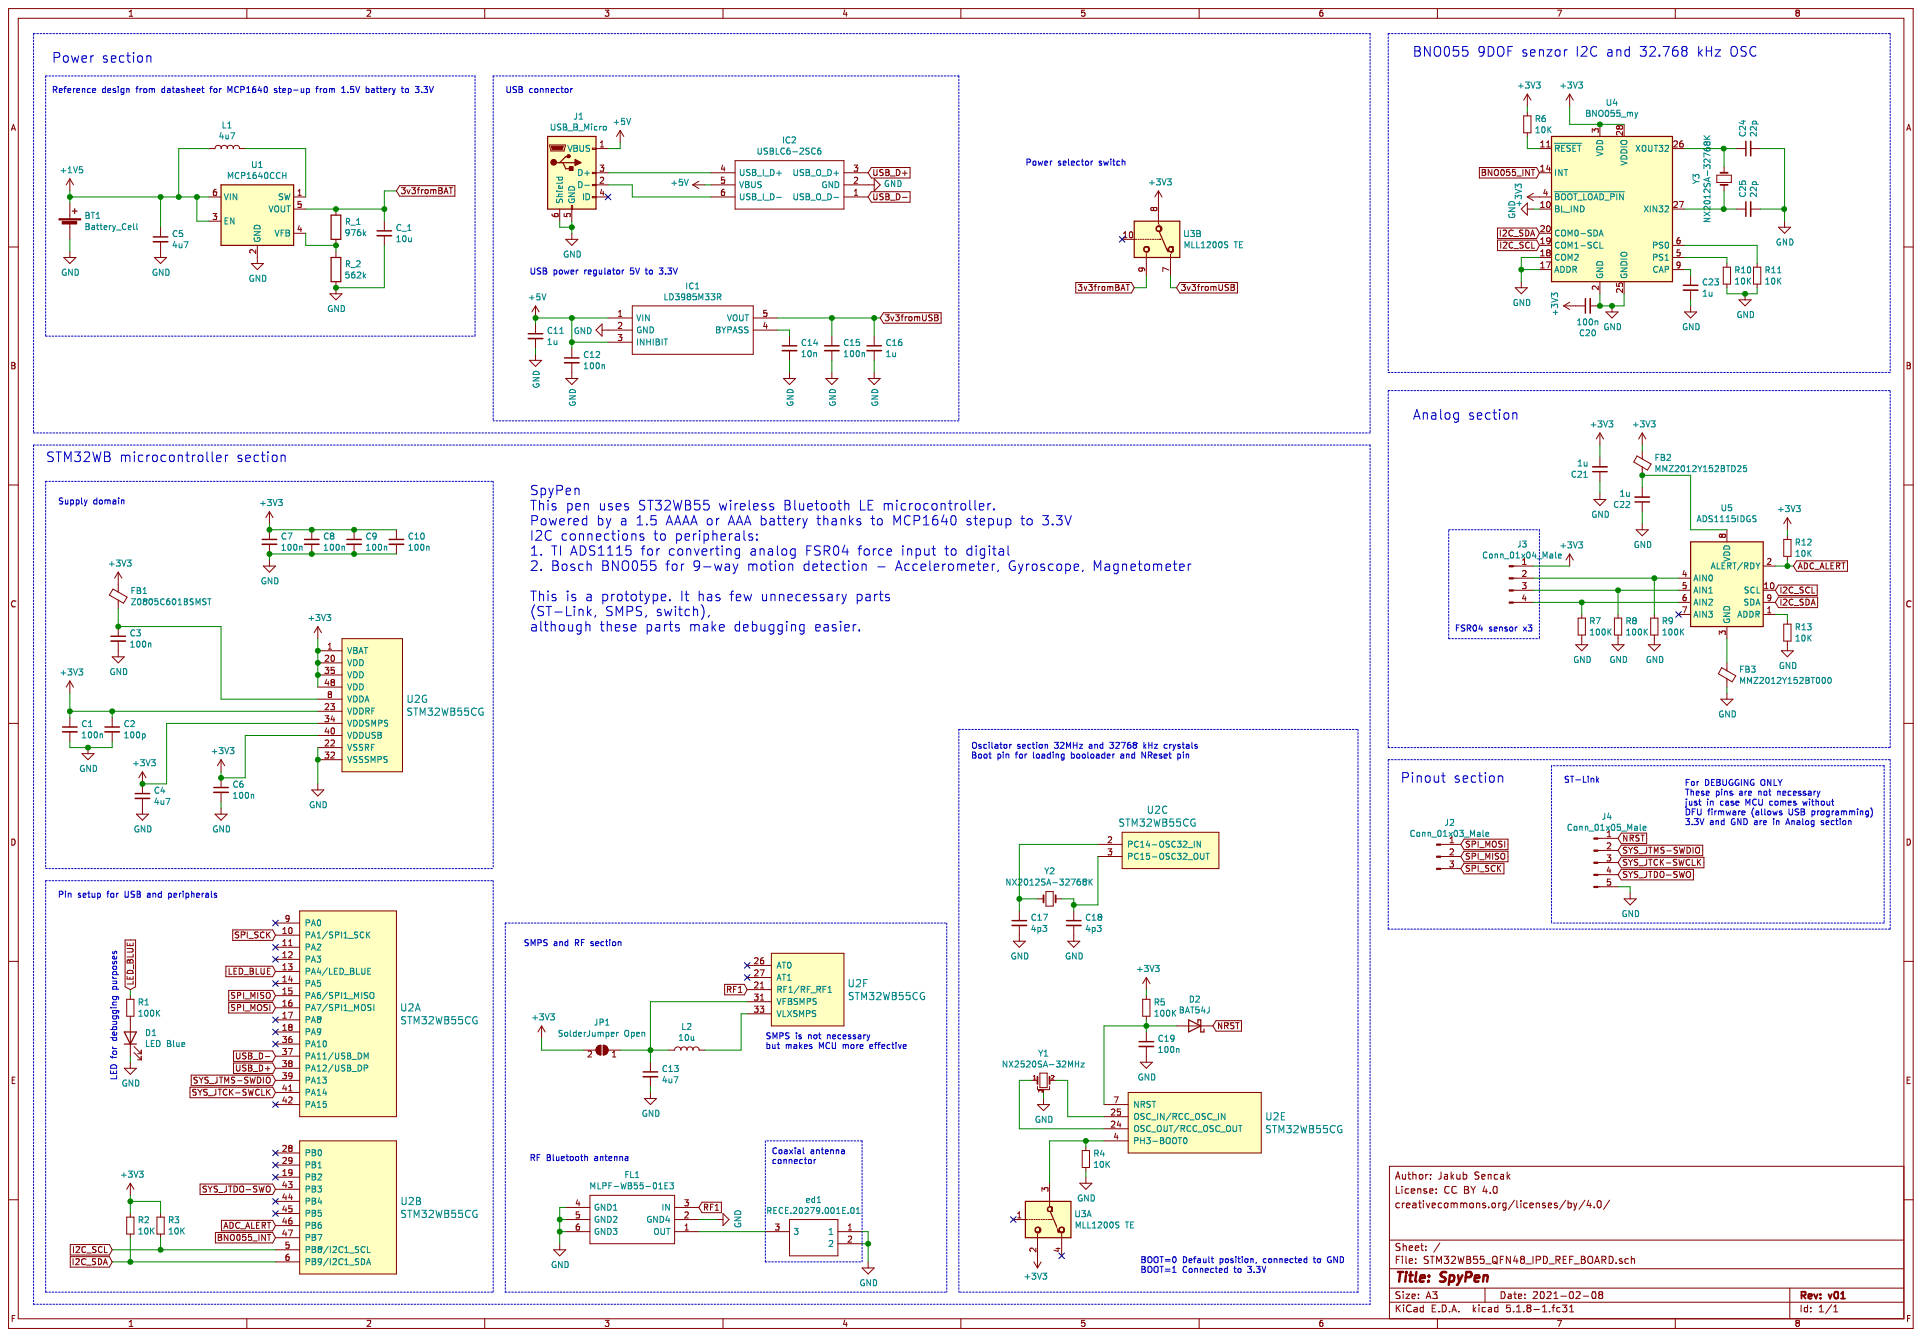
[picture p9: page 1]
