jsenlas/KiCAD_Bak/STM32WB55CG/STM32WB55_QFN48_IPD_REF_BOARD/07-Drill-Drawing/Drill_Drawing_STM32WB55_DB_QFN48_IPD.PDF

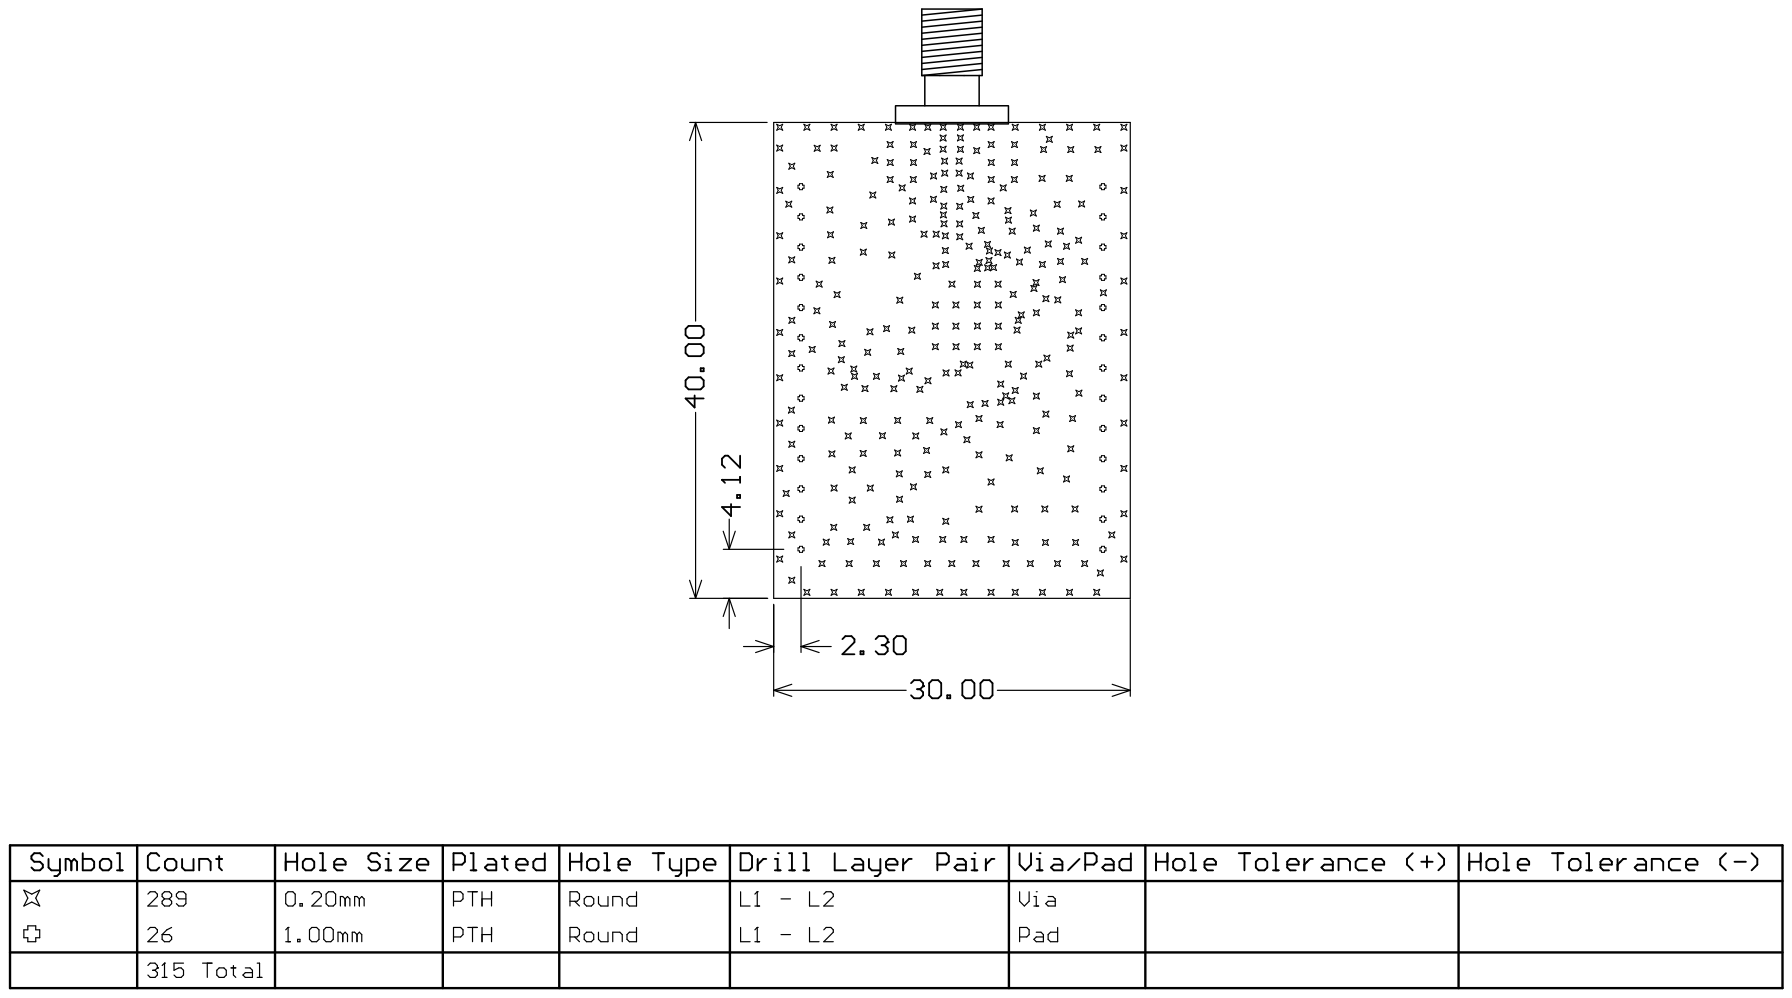
[picture p10: page 1]
