jsenlas/KiCAD_Bak/STM32WB55CG/STM32WB55_QFN48_IPD_REF_BOARD/05-Gerber files/Gerber Pdf/Gerber_STM32WB55_DB_QFN48_IPD.PDF

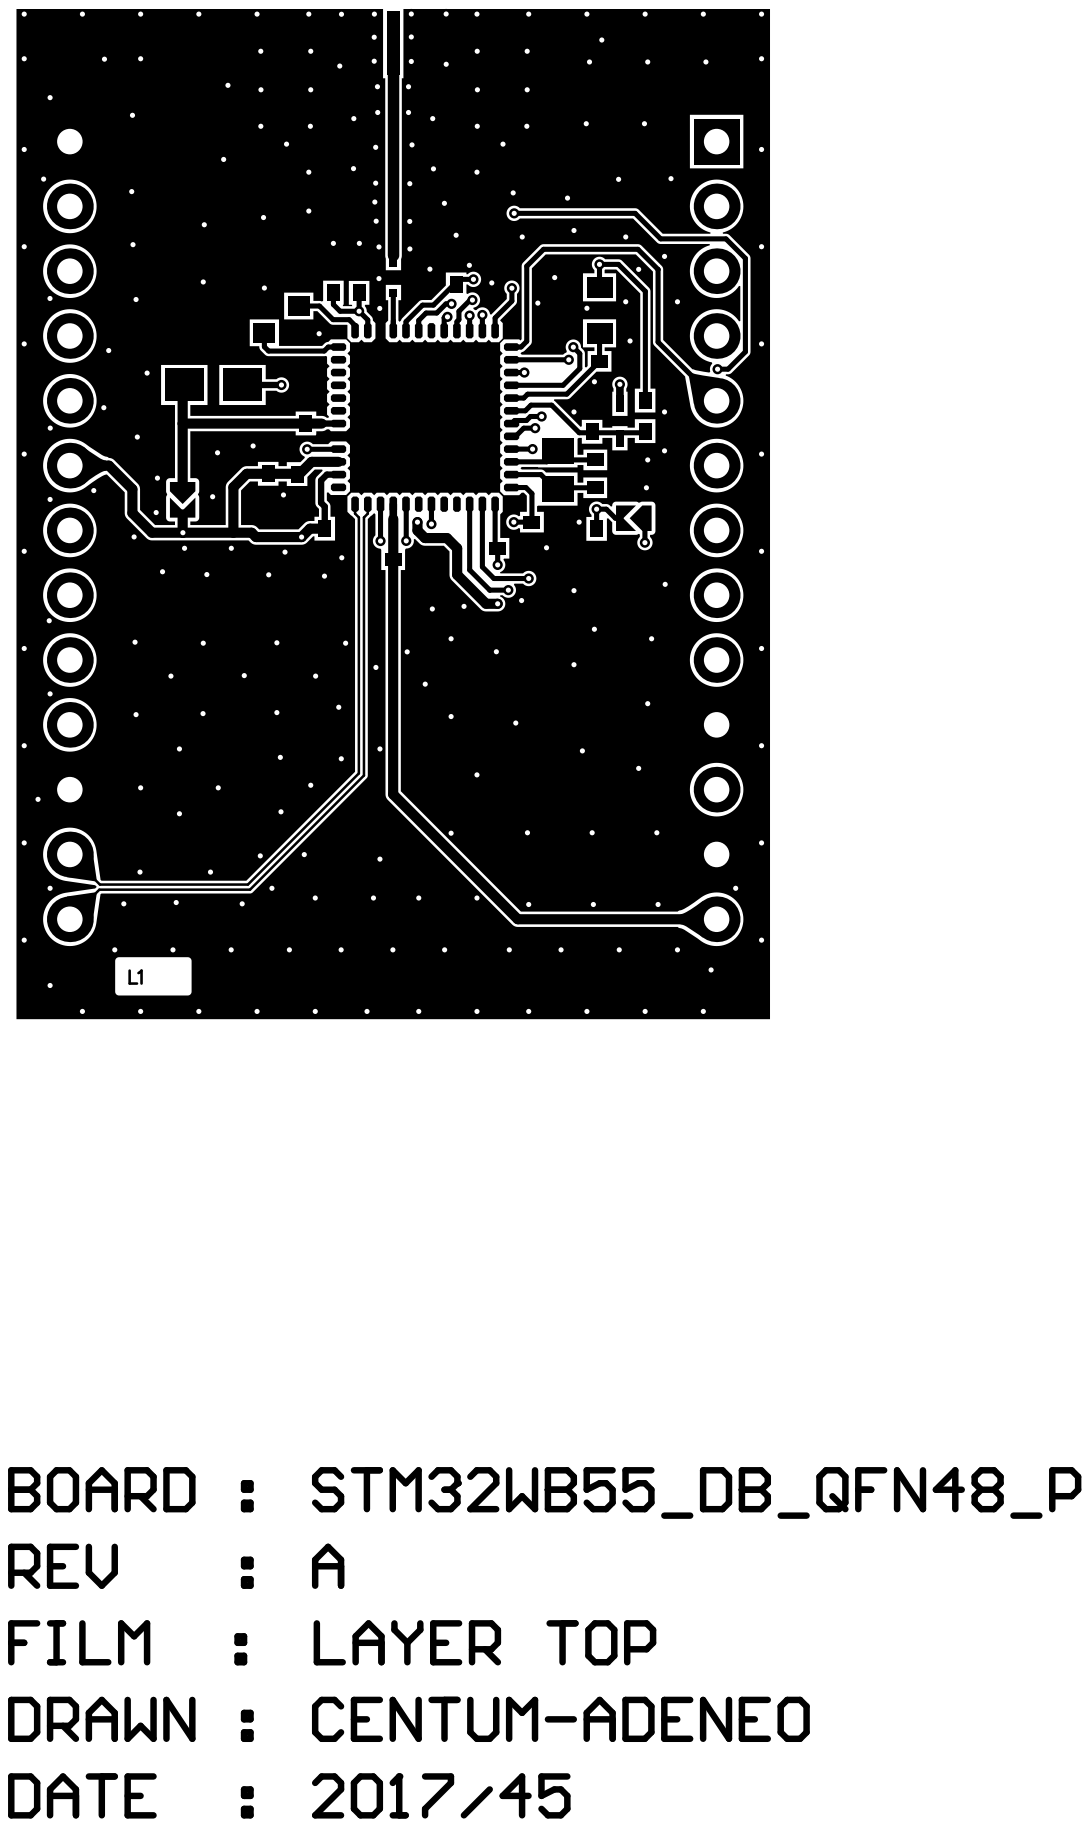
[picture p11: page 1]

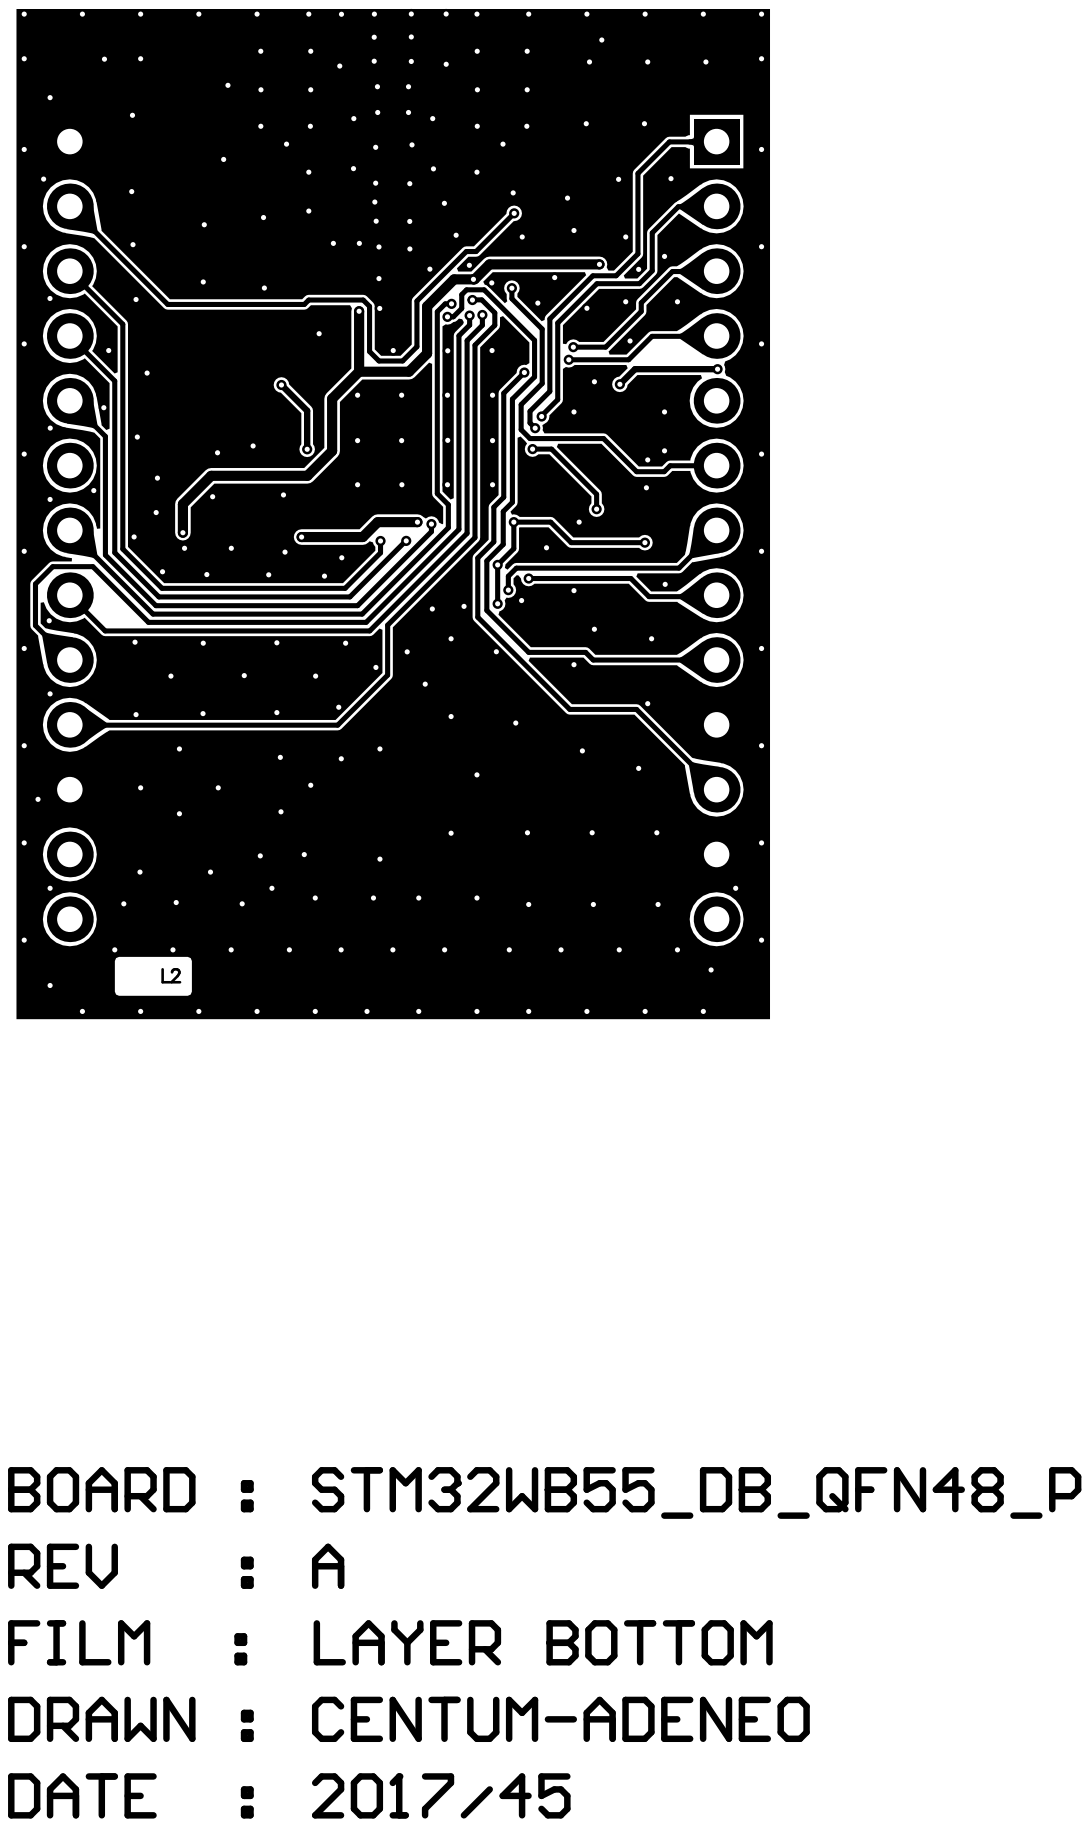
[picture p12: page 2]

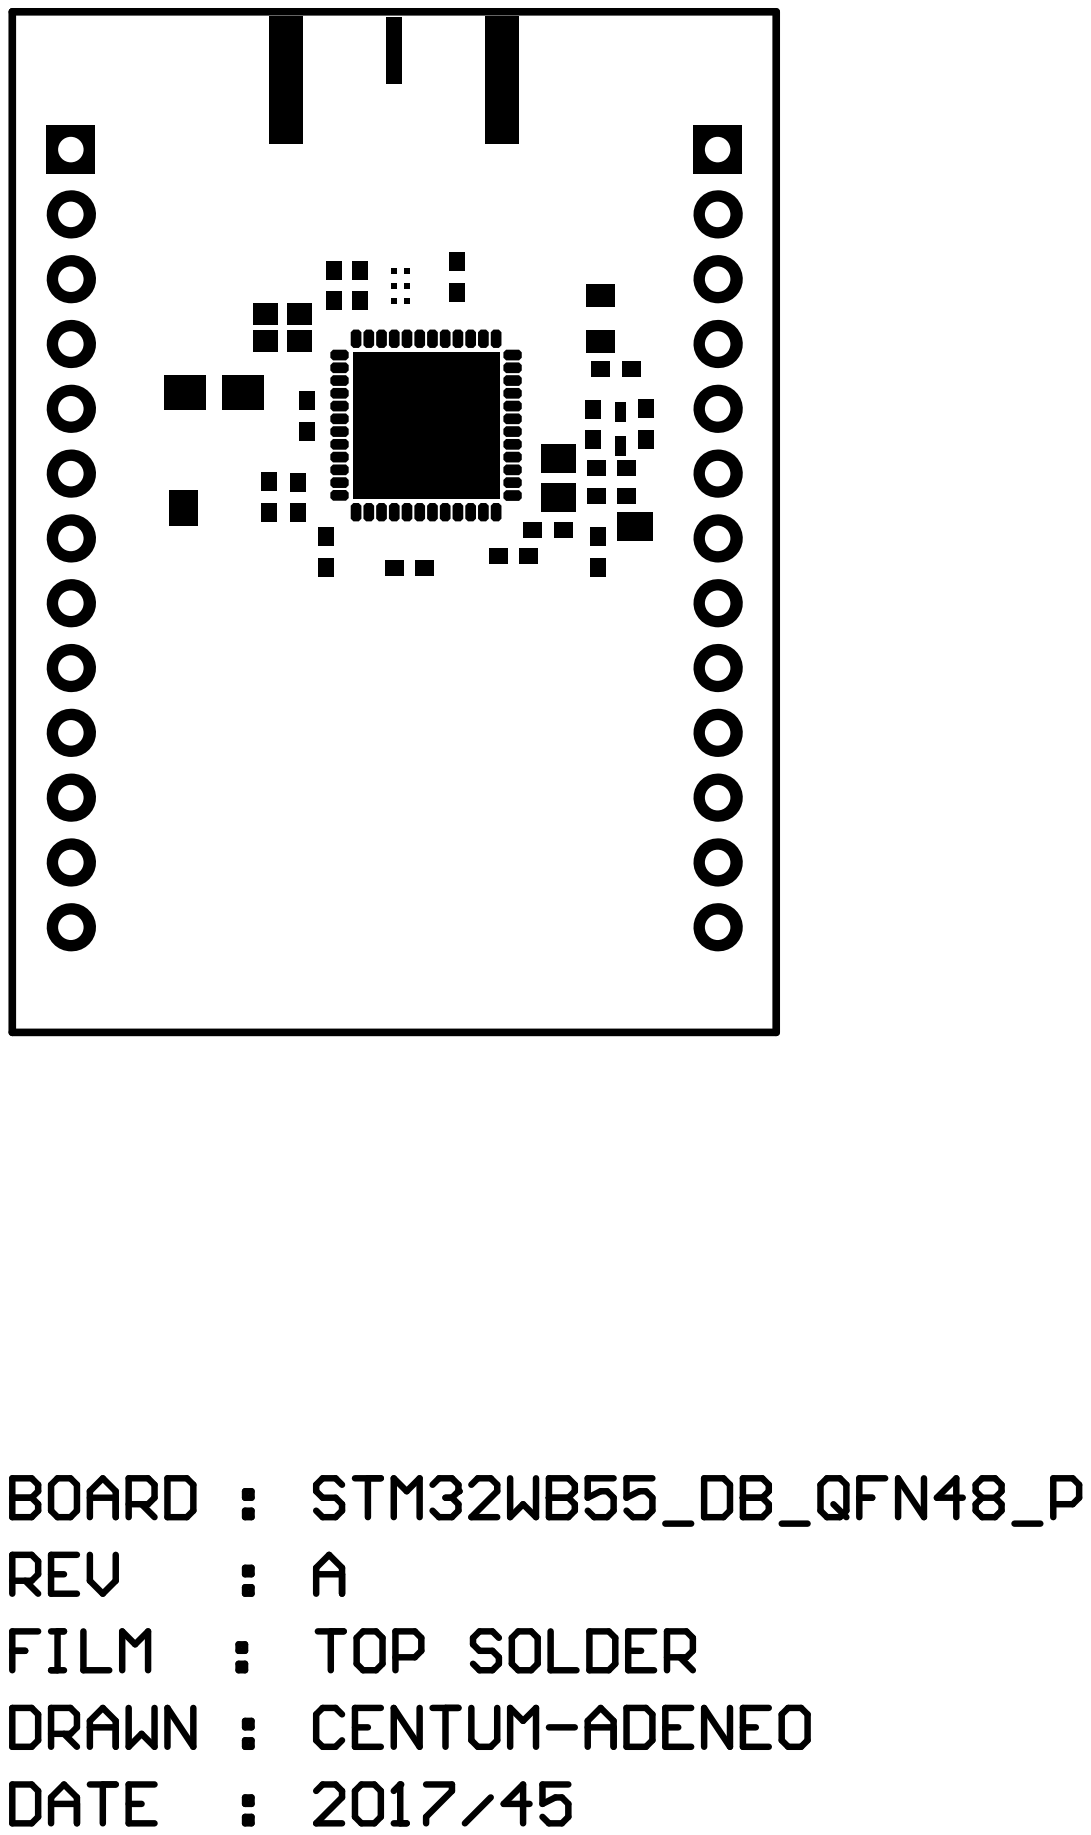
[picture p13: page 3]

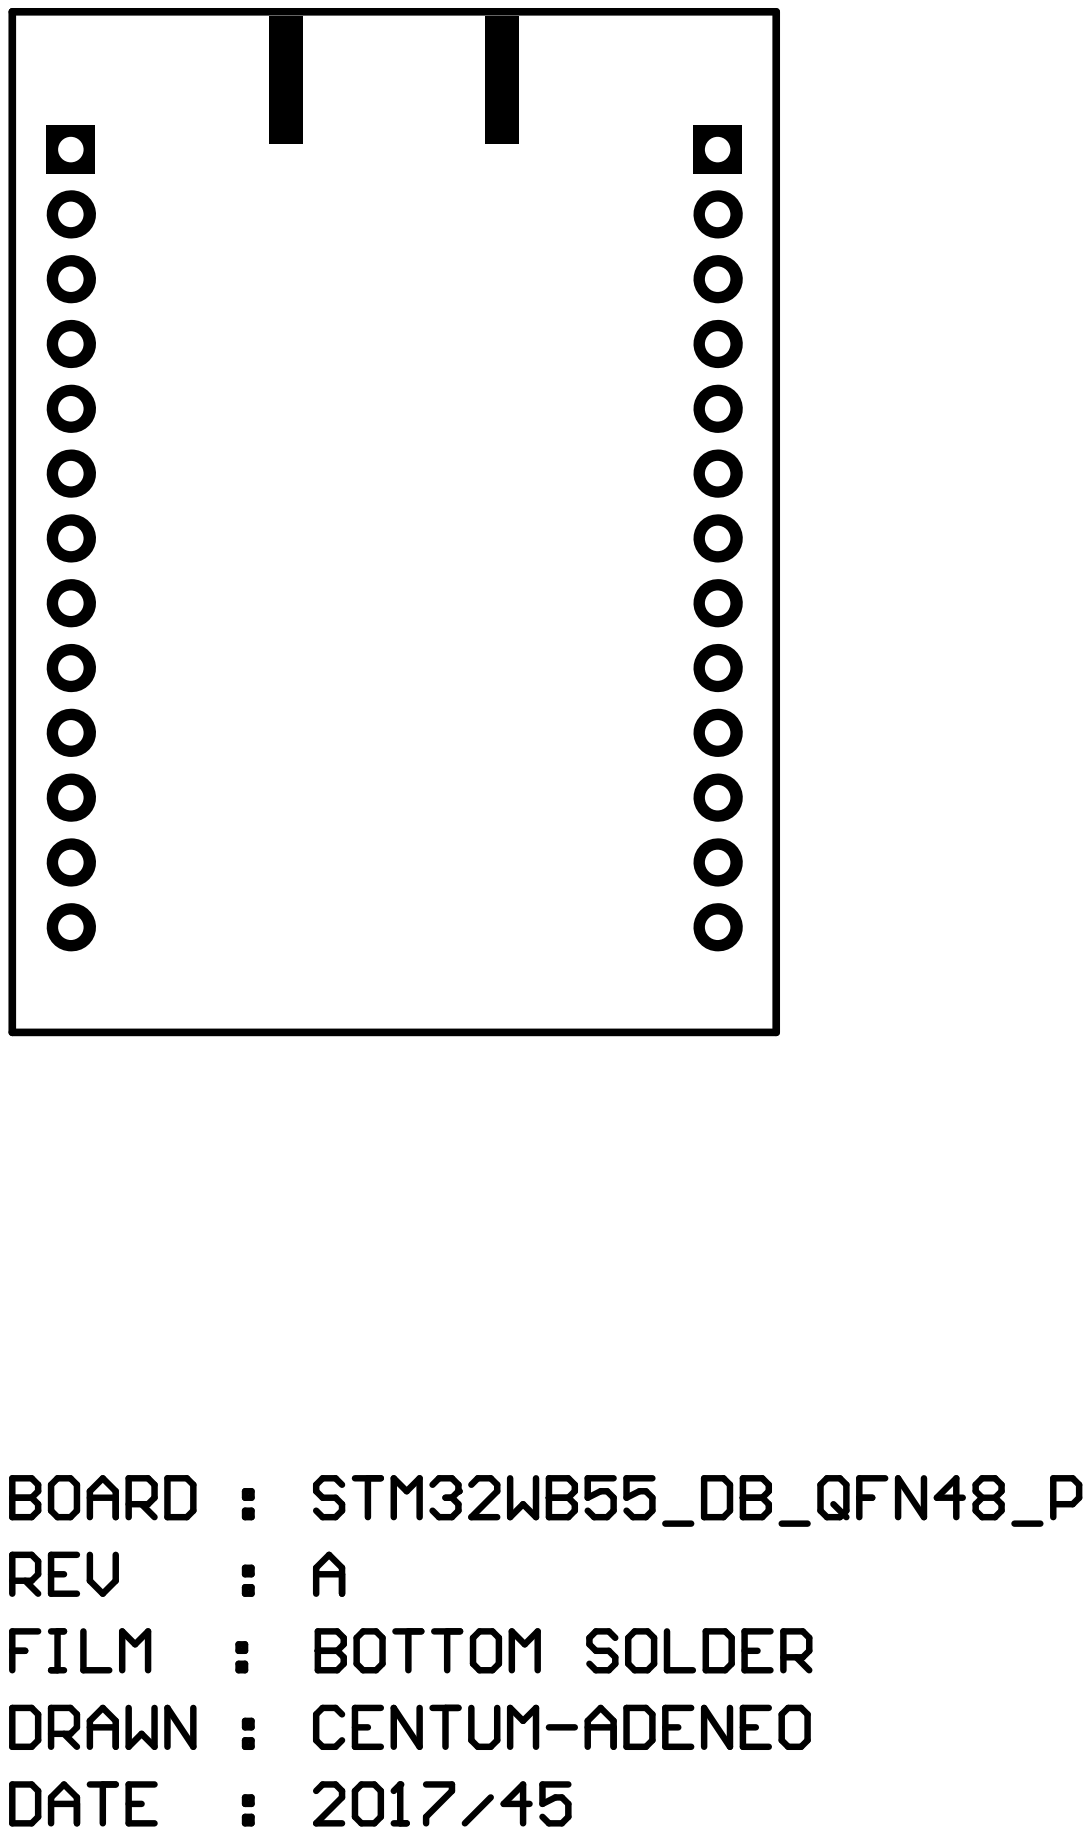
[picture p14: page 4]

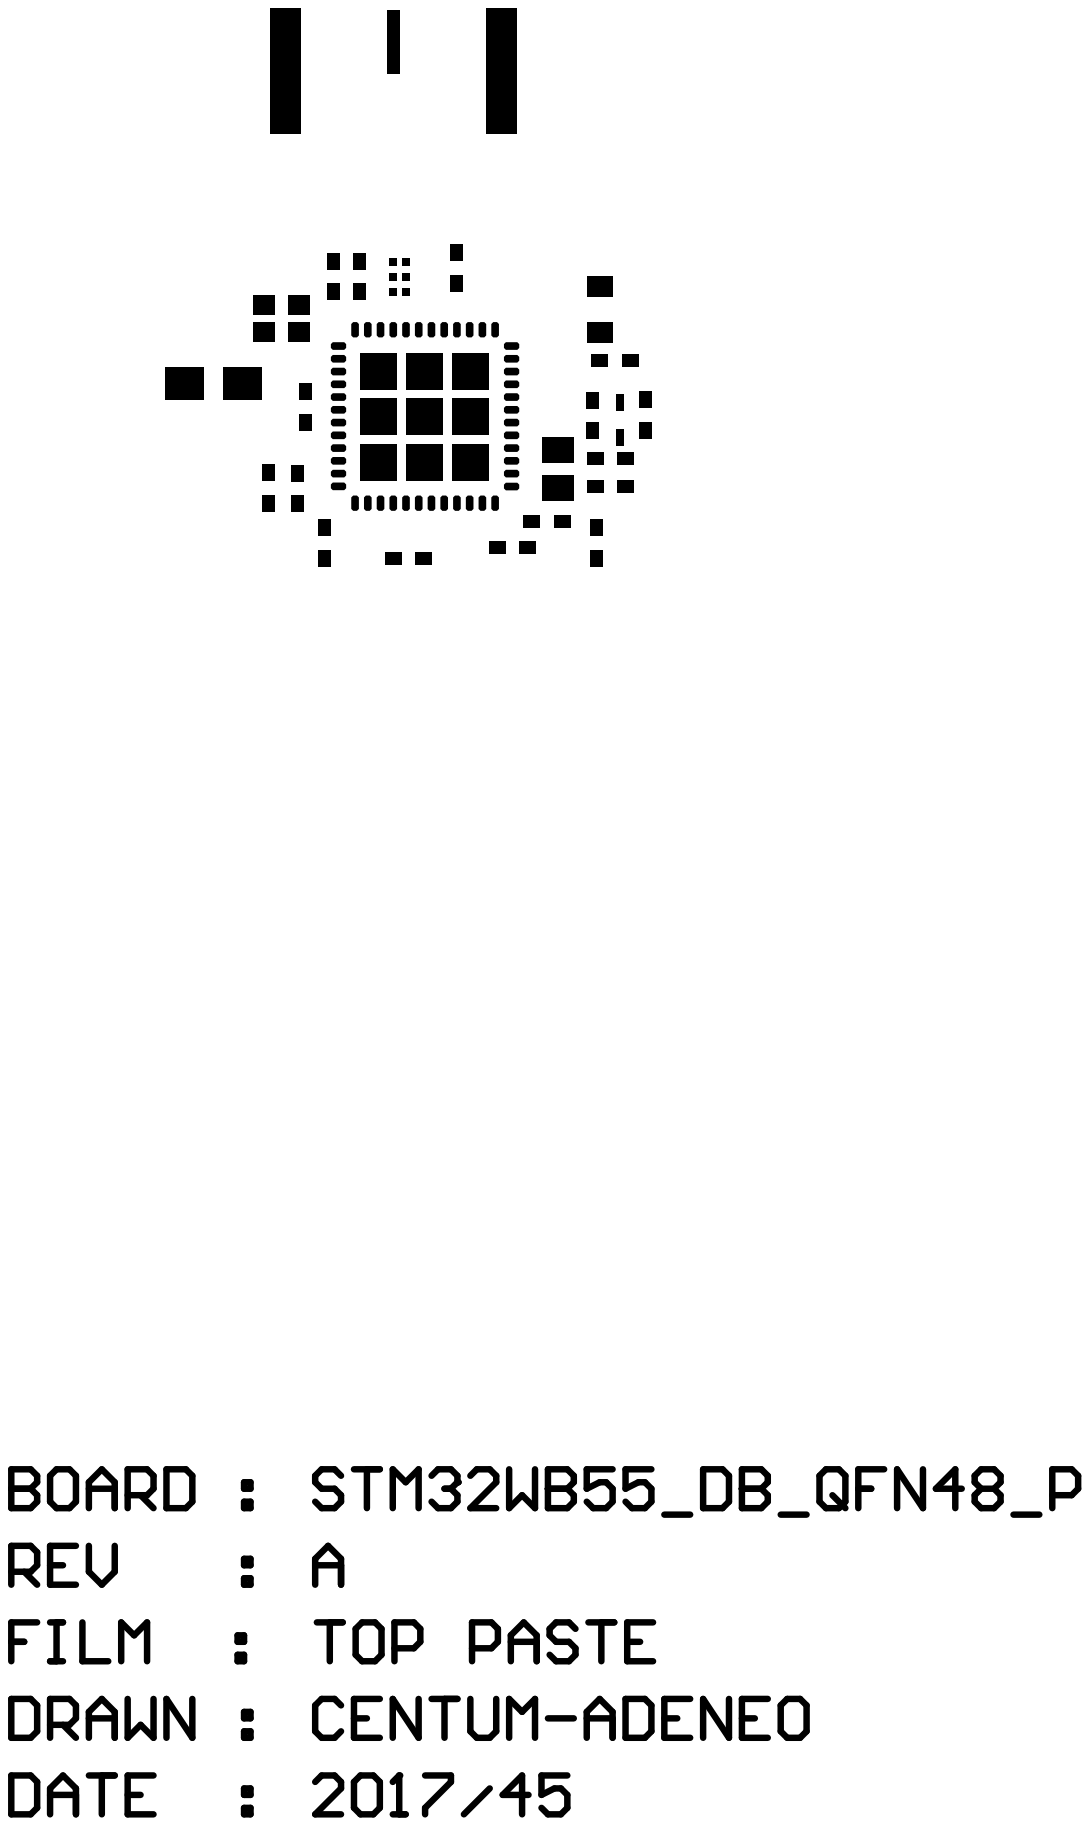
[picture p15: page 5]

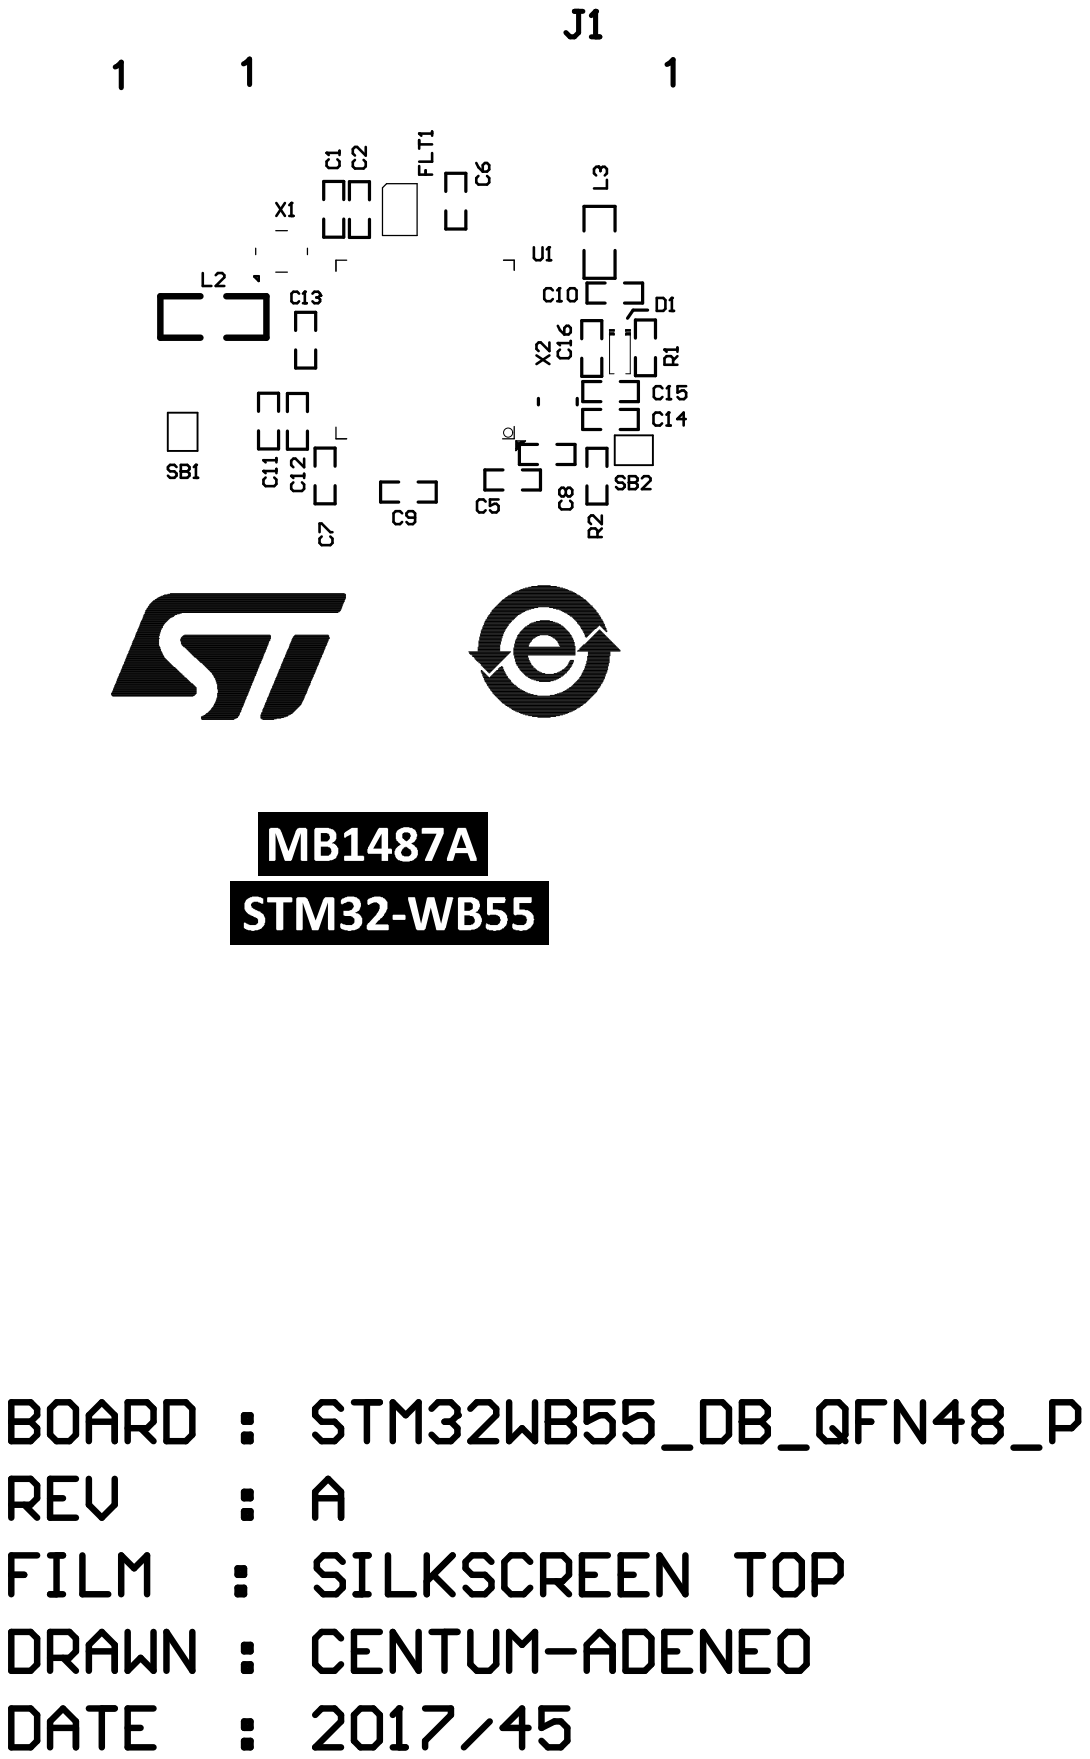
[picture p16: page 6]

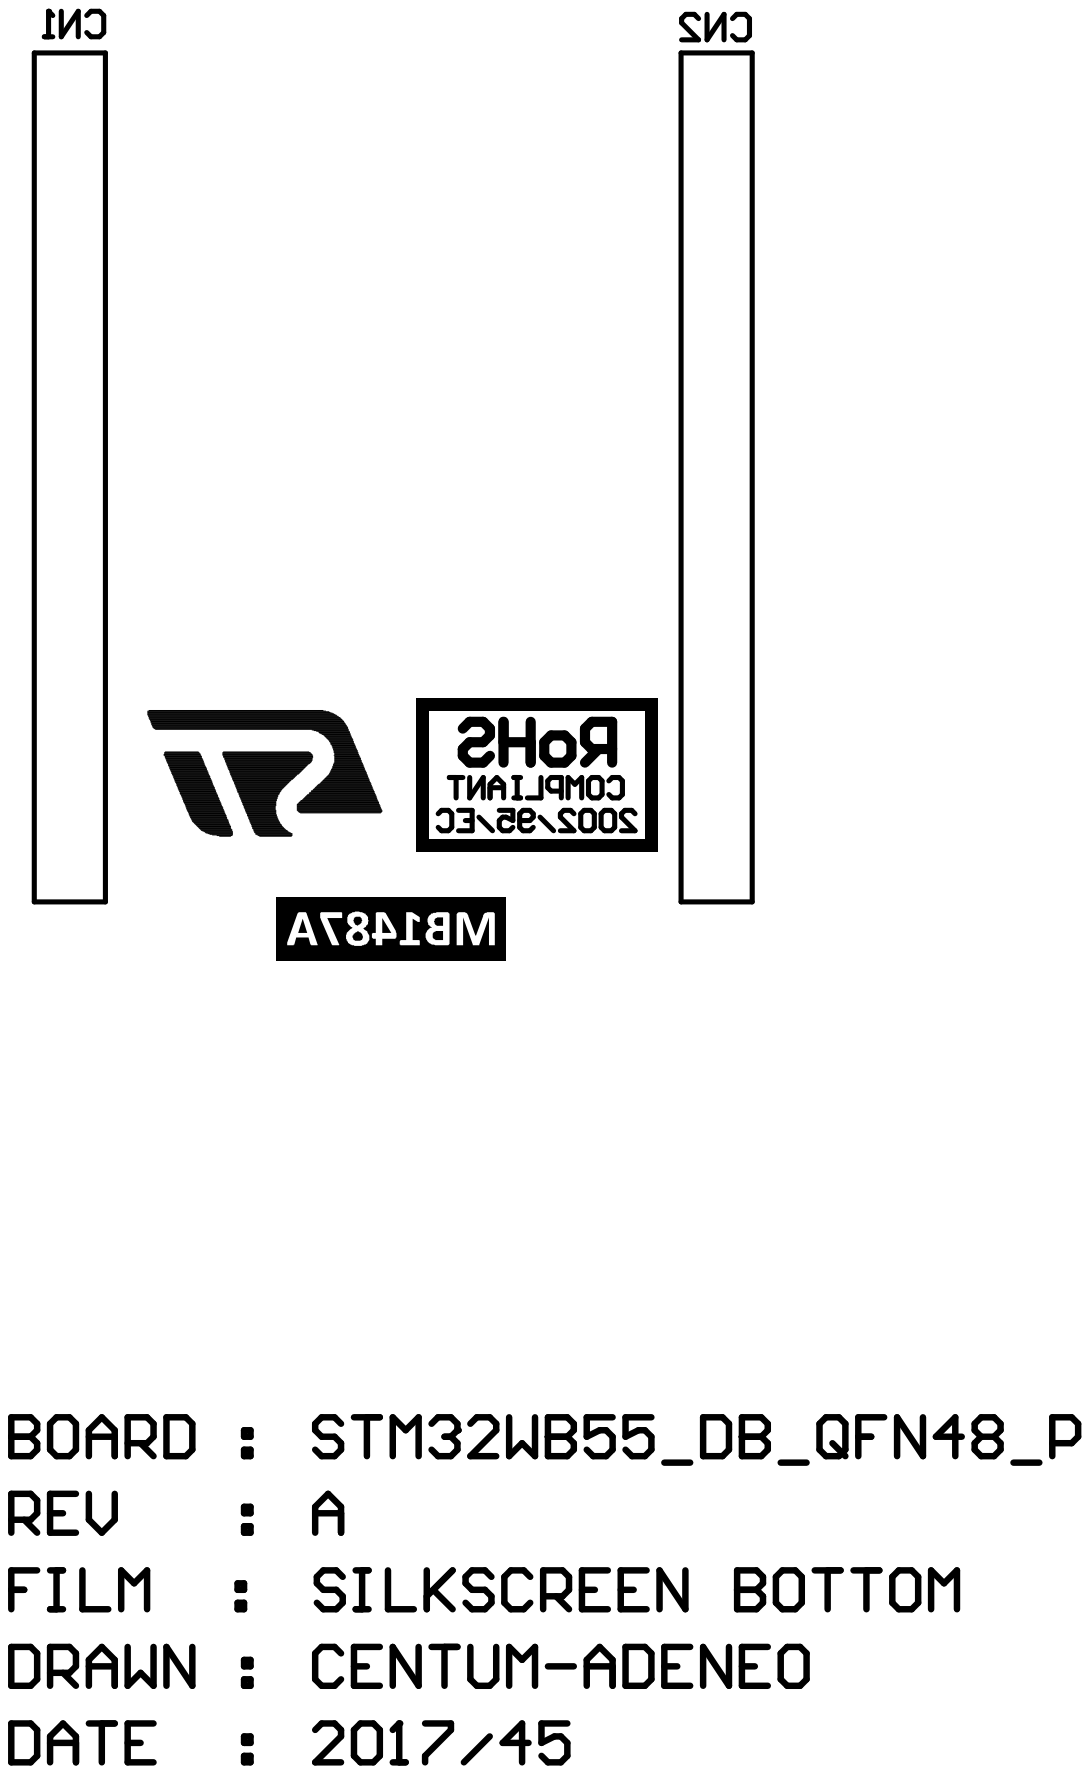
[picture p17: page 7]
