jsenlas/KiCAD_Bak/(list of files, drawings)

Other design files:
STM32WB55CG/STM32WB55_QFN48_IPD_REF_BOARD/03-Placement routage-PcbDoc/STM32WB55_DB_QFN48_IPD.PcbDoc
STM32WB55CG/STM32WB55_QFN48_IPD_REF_BOARD_FREEROUTED.dsn
STM32WB55CG/STM32WB55_QFN48_IPD_REF_BOARD_Freerouted_Newest.dsn
STM32WB55CG/STM32WB55_QFN48_IPD_REF_BOARD_v03.dsn
STM32WB55CG/STM32WB55_QFN48_IPD_REF_BOARD_v04.dsn
STM32WB55CG/STM32WB55_QFN48_IPD_REF_BOARD_v05.dsn
STM32WB55CG/STM32WB55_QFN48_IPD_REF_BOARD_v06.dsn
STM32WB55CG/STM32WB55_QFN48_IPD_REF_BOARD_v07.1.dsn
STM32WB55CG/STM32WB55_QFN48_IPD_REF_BOARD_v07.dsn
