jsenlas/KiCAD_Bak/STM32WB55CG/STM32WB55_QFN48_IPD_REF_BOARD.kicad_pcb

## KiCad design STM32WB55CG/STM32WB55_QFN48_IPD_REF_BOARD.kicad_pcb (2021-03-03)

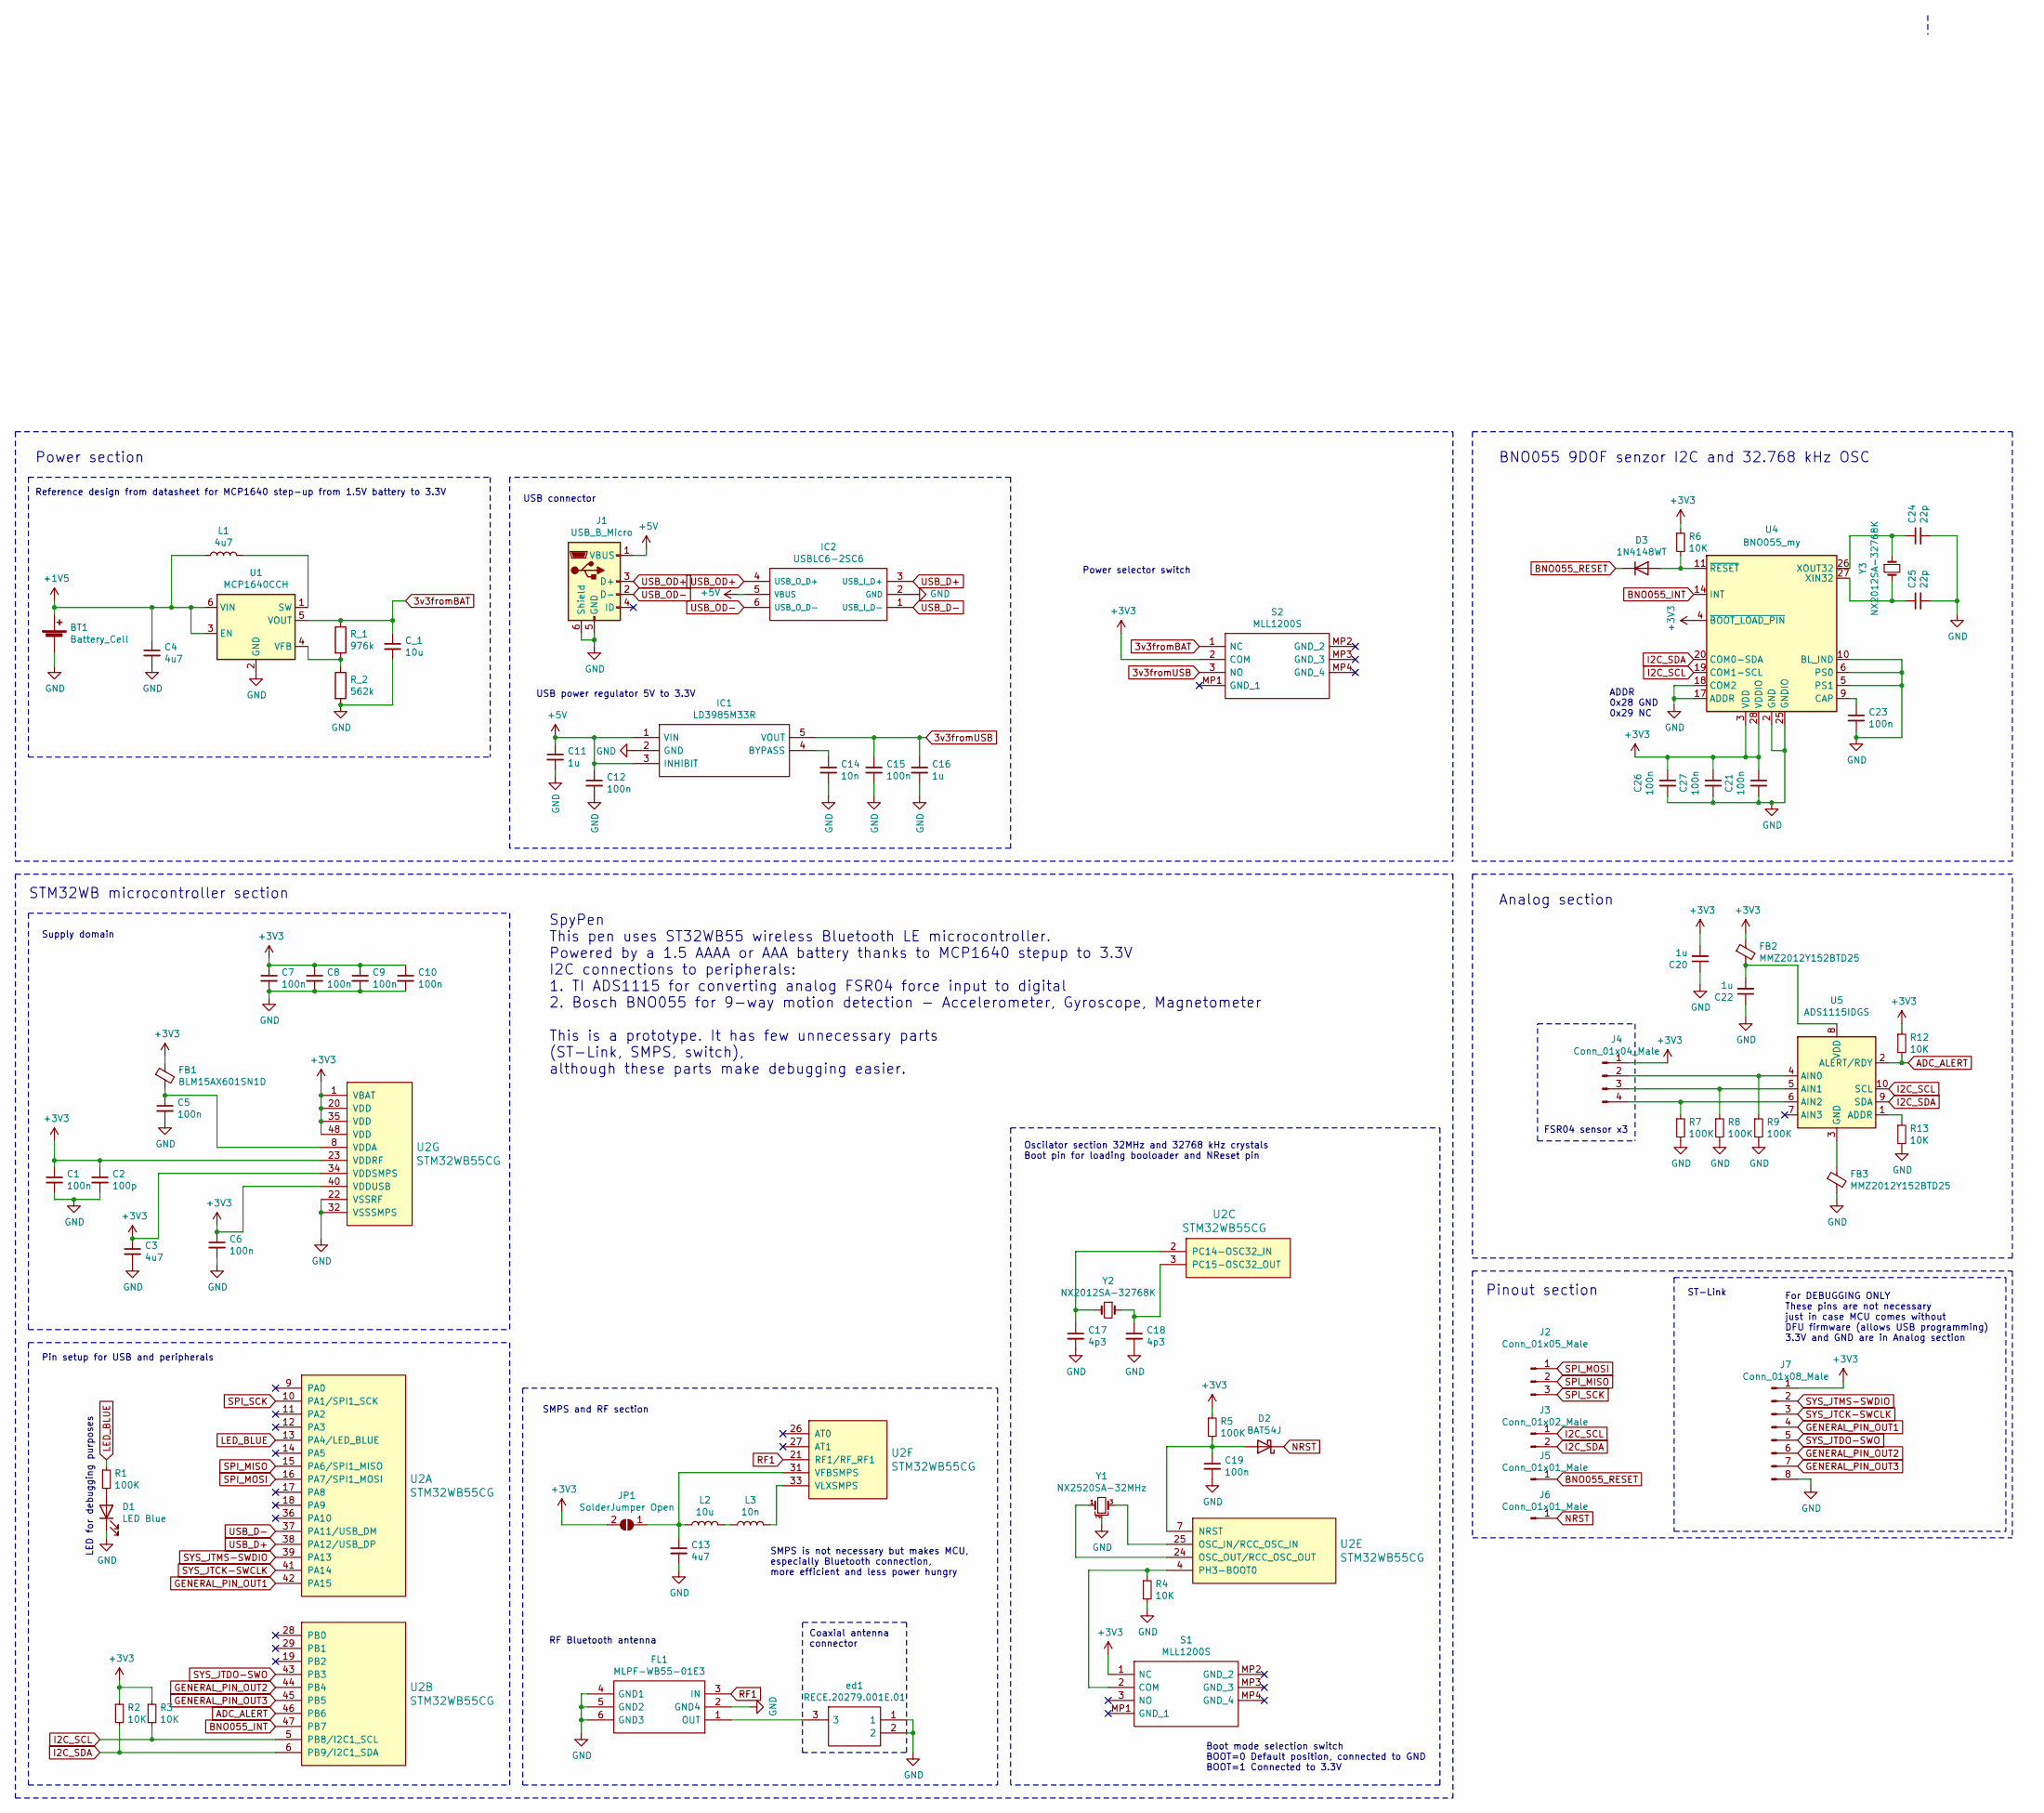
[picture p18: schematic STM32WB55_QFN48_IPD_REF_BOARD.sch, SpyPen]

Parts:
BT1: Battery_Cell; battery_connector_narrow
C1, C5, C6, C7, C8, C9, C10, C15, C19, C21, C23, C26, C27: 100n; C_0402_1005Metric
C2: 100p; C_0402_1005Metric
C3, C4, C13: 4u7; C_0402_1005Metric
C11, C16, C20, C22: 1u; C_0402_1005Metric
C12: 100n; C_0603_1608Metric
C14: 10n; C_0402_1005Metric
C17, C18: 4p3; C_0402_1005Metric
C24, C25: 22p; C_0402_1005Metric
C_1: 10u; C_0402_1005Metric
D1: LED Blue; LED_0603_1608Metric
D2: BAT54J; D_SOD-323F
D3: 1N4148WT; D_SOD-523
FB1: BLM15AX601SN1D; R_0402_1005Metric
FB2, FB3: MMZ2012Y152BTD25; R_0402_1005Metric
FL1: MLPF-WB55-01E3; MLPF-WB55-02E3; Manufacturer_Part_Number MLPF-WB55-01E3; Mouser Part Number 511-MLPF-WB55-01E3
IC1: LD3985M33R; SOT-23-5; Manufacturer_Part_Number LD3985M33R; Mouser Part Number 511-LD3985M33R
IC2: USBLC6-2SC6; SOT-23-6; Manufacturer_Part_Number USBLC6-2SC6; Mouser Part Number 511-USBLC6-2SC6
J1: USB_B_Micro; UB-MC5BR3-SDWP604-4S-TF
J2: Conn_01x05_Male; pin_03
J3: Conn_01x02_Male; pin_02
J4: Conn_01x04_Male; Pin_FSR
J5, J6: Conn_01x01_Male; pin_01
J7: Conn_01x08_Male; pin_08
JP1: SolderJumper Open; SolderJumper-2_P1.3mm_Open_TrianglePad1.0x1.5mm
L1: 4u7; L_0603_1608Metric
L2: 10u; L_0712_SMD
L3: 10n; L_0603_1608Metric
R1, R5, R7, R8, R9: 100K; R_0402_1005Metric
R2, R3, R4, R6, R12, R13: 10K; R_0402_1005Metric
R_1: 976k; R_0402_1005Metric
R_2: 562k; R_0402_1005Metric
S1, S2: MLL1200S; Manufacturer_Part_Number MLL1200S; Mouser Part Number 506-MLL1200S
U1: MCP1640CCH; SOT-23-6
U2: STM32WB55CG; STM32WB55CGU7
U4: BNO055_my; LGA-28_5.2x3.8mm_P0.5mm
U5: ADS1115IDGS; ADS1115IRUGR
Y1: NX2520SA-32MHz; Crystal_SMD_2520-4Pin_2.5x2.0mm
Y2, Y3: NX2012SA-32768K; Crystal_2012_custom
ed1: RECE.20279.001E.01; Manufacturer_Part_Number RECE.20279.001E.01; Mouser Part Number N/A

Connections:
3v3fromBAT: C_1.1, R_1.1, S2.1 (NC), U1.5 (VOUT)
3v3fromUSB: C15.1, C16.1, IC1.5 (VOUT), S2.3 (NO)
+1V5: BT1.1 (+), C4.1, L1.1, U1.3 (EN), U1.6 (VIN)
+3V3: C1.1, C2.1, C3.1, C6.1, C7.1, C8.1, C9.1, C10.1, C20.2, C21.1, C26.1, C27.1, FB1.1, FB2.1, J4.1, J7.1, JP1.2 (B), R2.1, R3.1, R5.1, R6.1, R12.1, S1.1 (NC), S2.2 (COM), U2.1 (VBAT), U2.20 (VDD), U2.23 (VDDRF), U2.34 (VDDSMPS), U2.35 (VDD), U2.40 (VDDUSB), U2.48 (VDD), U4.3 (VDD), U4.4 (~BOOT_LOAD_PIN), U4.28 (VDDIO)
+5V: C11.1, C12.1, IC1.1 (VIN), IC1.3 (INHIBIT), IC2.5 (VBUS), J1.1 (VBUS)
ADC_ALERT: R12.2, U2.46 (PB6), U5.2 (ALERT/RDY)
BNO055_INT: U2.47 (PB7), U4.14 (INT)
BNO055_RESET: D3.1 (K), J5.1
GENERAL_PIN_OUT1: J7.4, U2.42 (PA15)
GENERAL_PIN_OUT2: J7.6, U2.44 (PB4)
GENERAL_PIN_OUT3: J7.7, U2.45 (PB5)
GND: BT1.2 (-), C1.2, C2.2, C3.2, C4.2, C5.2, C6.2, C7.2, C8.2, C9.2, C10.2, C11.2, C12.2, C13.2, C14.2, C15.2, C16.2, C17.2, C18.2, C19.2, C20.1, C21.2, C22.1, C23.2, C24.2, C25.2, C26.2, C27.2, C_1.2, D1.1 (K), FB3.2, FL1.2 (GND4), FL1.4 (GND1), FL1.5 (GND2), FL1.6 (GND3), IC1.2 (GND), IC2.2 (GND), J1.5 (GND), J1.6 (Shield), J7.8, R4.2, R7.2, R8.2, R9.2, R13.2, R_2.2, U1.2 (GND), U2.22 (VSSRF), U2.32 (VSSSMPS), U2.49, U4.2 (GND), U4.5 (PS1), U4.6 (PS0), U4.10 (BL_IND), U4.15 (GNDIO), U4.16 (GNDIO), U4.17 (ADDR), U4.18 (COM2), U4.25 (GNDIO), Y1.2, Y1.4, ed1.1, ed1.2
I2C_SCL: J3.1, R3.2, U2.5 (PB8/I2C1_SCL), U4.19 (COM1-SCL), U5.10 (SCL)
I2C_SDA: J3.2, R2.2, U2.6 (PB9/I2C1_SDA), U4.20 (COM0-SDA), U5.9 (SDA)
LED_BLUE: R1.1, U2.13 (PA4/LED_BLUE)
NRST: D2.1 (K), J6.1
unnamed: C5.1, FB1.2, U2.8 (VDDA)
unnamed: C13.1, JP1.1 (A), L2.1, U2.31 (VFBSMPS)
unnamed: C14.1, IC1.4 (BYPASS)
unnamed: C17.1, U2.2 (PC14-OSC32_IN), Y2.2
unnamed: C18.1, U2.3 (PC15-OSC32_OUT), Y2.1
unnamed: C19.1, D2.2 (A), R5.2, U2.7 (NRST)
unnamed: C22.2, FB2.2, U5.8 (VDD)
unnamed: C23.1, U4.9 (CAP)
unnamed: C24.1, U4.26 (XOUT32), Y3.1
unnamed: C25.1, U4.27 (XIN32), Y3.2
unnamed: D1.2 (A), R1.2
unnamed: D3.2 (A), R6.2, U4.11 (~RESET)
unnamed: FB3.1, U5.3 (GND)
unnamed: FL1.1 (OUT), ed1.3
unnamed: J4.2, R9.1, U5.4 (AIN0)
unnamed: J4.3, R8.1, U5.5 (AIN1)
unnamed: J4.4, R7.1, U5.6 (AIN2)
unnamed: L1.2, U1.1 (SW)
unnamed: L2.2, L3.1
unnamed: L3.2, U2.33 (VLXSMPS)
unnamed: R4.1, S1.2 (COM), U2.4 (PH3-BOOT0)
unnamed: R13.1, U5.1 (ADDR)
unnamed: R_1.2, R_2.1, U1.4 (VFB)
unnamed: U2.24 (OSC_OUT/RCC_OSC_OUT), Y1.1
unnamed: U2.25 (OSC_IN/RCC_OSC_IN), Y1.3
RF1: FL1.3 (IN), U2.21 (RF1/RF_RF1)
SPI_MISO: J2.2, U2.15 (PA6/SPI1_MISO)
SPI_MOSI: J2.1, U2.16 (PA7/SPI1_MOSI)
SPI_SCK: J2.3, U2.10 (PA1/SPI1_SCK)
SYS_JTCK-SWCLK: J7.3, U2.41 (PA14)
SYS_JTDO-SWO: J7.5, U2.43 (PB3)
SYS_JTMS-SWDIO: J7.2, U2.39 (PA13)
USB_D+: IC2.3 (USB_I_D+), U2.38 (PA12/USB_DP)
USB_D-: IC2.1 (USB_I_D-), U2.37 (PA11/USB_DM)
USB_OD+: IC2.4 (USB_O_D+), J1.3 (D+)
USB_OD-: IC2.6 (USB_O_D-), J1.2 (D-)

Notes on the sheet:
Analog section
USB connector
RF Bluetooth antenna
Supply domain
Oscilator section 32MHz and 32768 kHz crystals Boot pin for loading booloader and NReset pin
Pin setup for USB and peripherals
SMPS and RF section
Reference design from datasheet for MCP1640 step-up from 1.5V battery to 3.3V
USB power regulator 5V to 3.3V
Boot mode selection switch BOOT=0 Default position, connected to GND BOOT=1 Connected to 3.3V
LED for debugging purposes
Coaxial antenna connector
BNO055 9DOF senzor I2C and 32.768 kHz OSC
Pinout section
FSR04 sensor x3
For DEBUGGING ONLY These pins are not necessary just in case MCU comes without DFU firmware (allows USB programming) 3.3V and GND are in Analog section
ST-Link
SMPS is not necessary but makes MCU, especially Bluetooth connection, more efficient and less power hungry
STM32WB microcontroller section
Power section
Power selector switch
SpyPen This pen uses ST32WB55 wireless Bluetooth LE microcontroller. Powered by a 1.5 AAAA or AAA battery thanks to MCP1640 stepup to 3.3V I2C connections to peripherals: 1. TI ADS1115 for converting analog FSR04 force input to digital 2. Bosch BNO055 for 9-way motion detection - Accelerometer, Gyr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
ADDR 0x28 GND 0x29 NC

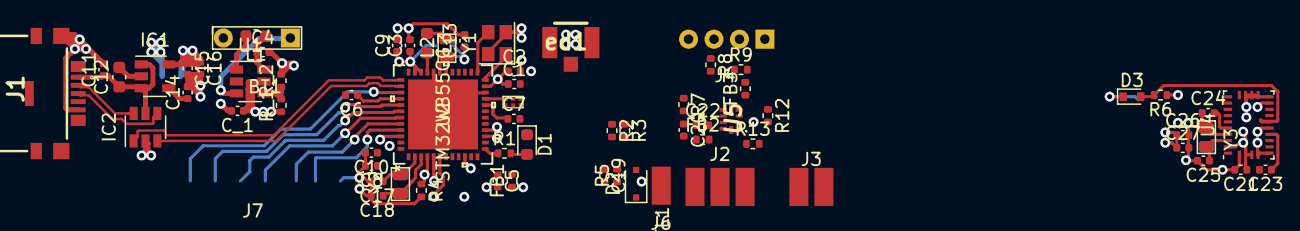
[picture p19: board STM32WB55_QFN48_IPD_REF_BOARD.kicad_pcb from above]

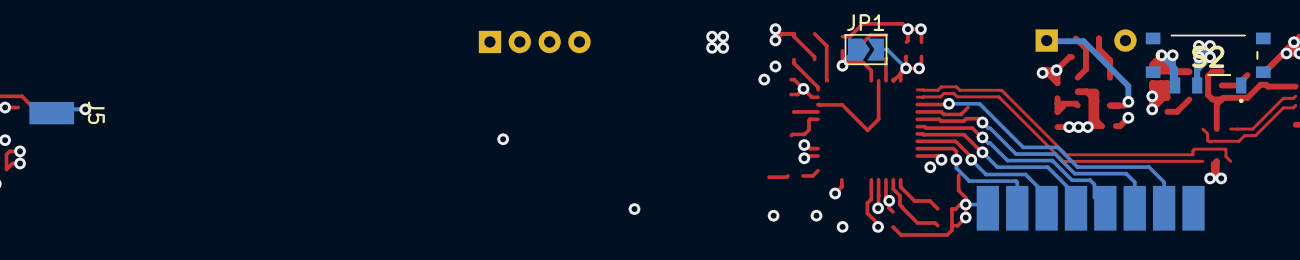
[picture p20: board STM32WB55_QFN48_IPD_REF_BOARD.kicad_pcb from below]

Board: 4 copper layers, 71 parts (3 on the bottom side), 52 nets.
