jsenlas/KiCAD_Bak/(commit log)

2021-02-12 schema complete
    [Pinout.ods, STM32WB55_QFN48_IPD_REF_BOARD.kicad_pcb, STM32WB55_QFN48_IPD_REF_BOARD.sch, nepotrebne suciastky.kicad_pcb, nepotrebne suciastky.sch, pinoutST32RFWithoutbs.csv]
2021-02-17 assign footprints complete need one more look and a check from Simek
    [BOM01.csv, BOM_nakup_00.csv, BOMv00.csv, STM32WB55_QFN48_IPD_REF_BOARD.kicad_pcb, STM32WB55_QFN48_IPD_REF_BOARD.sch, STM32WB55_QFN48_IPD_REF_BOARD_FREEROUTED.dsn, STM32WB55_QFN48_IPD_REF_BOARD_Freerouted_Newest.dsn]
2021-02-25 dokoncene rozlozenie okolo STM32WB podla referencneho dizajnu
    [BOM_Senčák HW.xlsx, STM32WB55_QFN48_IPD_REF_BOARD.kicad_pcb, STM32WB55_QFN48_IPD_REF_BOARD.sch, STM32WB55_QFN48_IPD_REF_BOARD_v03.dsn, STM32WB55_QFN48_IPD_REF_BOARD_v04.dsn, STM32WB55_QFN48_IPD_REF_BOARD_v05.dsn, STM32WB55_QFN48_IPD_REF_BOARD_v06.dsn]
2021-03-03 in the middle of moving libs
    [STM32WB55_QFN48_IPD_REF_BOARD.kicad_pcb, STM32WB55_QFN48_IPD_REF_BOARD.sch, STM32WB55_QFN48_IPD_REF_BOARD_v07.1.dsn, STM32WB55_QFN48_IPD_REF_BOARD_v07.dsn]
