jsenlas/KiCAD_Bak/(notices)

Notices in the files:
STM32WB55CG/STM32WB55_QFN48_IPD_REF_BOARD.sch:
creativecommons.org/licenses/by/4.0
License: CC BY 4.0
parts and their libraries:
Copyright 2016 Accelerated Designs. All rights reserved.
